NguyenHuynh-2004/Robot_kho/docs/TONG_HOP_DU_AN.docx

# Tổng hợp dự án xe tự hành AGV

Xe hai bánh vi sai chạy ROS 2 — ESP32, LiDAR, IMU, Nav2

Cập nhật: 01/10/2026 · Đang ở giai đoạn: định vị trên xe thật

Tóm tắt trong 30 giây

- Mục tiêu: xe tự chạy trong phòng. Người dùng chọn một ô trên lưới, xe tự tìm đường tới đó và tự tránh vật cản.
- Đã xong: chạy hoàn chỉnh trong mô phỏng. Trên xe thật: kết nối ổn định, lái tay được, hiệu chỉnh xong cảm biến, vẽ xong bản đồ phòng.
- Đang làm: cho xe tự biết mình đang ở đâu trên bản đồ (định vị bằng AMCL). Lần thử đầu còn lệch khoảng 8 cm, mục tiêu dưới 5 cm.
- Tiếp theo: sửa lỗi định vị, chỉnh lưới cho vừa phòng thật, rồi cho xe tự lái lần đầu.

# 1. Dự án làm gì

AGV (Automated Guided Vehicle) là xe tự hành. Xe trong dự án này nhỏ (đường kính 18 cm), có hai bánh chủ động phía sau và một bánh đa hướng phía trước. Xe rẽ bằng cách cho hai bánh quay khác tốc độ nhau — kiểu này gọi là “vi sai”.

Trên xe có ba loại cảm biến: LiDAR quét khoảng cách 360° xung quanh, encoder đếm số vòng quay của bánh, và IMU đo góc quay của xe. Vi điều khiển ESP32 đọc các cảm biến này rồi gửi qua Wi-Fi cho laptop. Laptop chạy ROS 2 để tính vị trí xe, vẽ bản đồ, lập đường đi, rồi gửi lệnh vận tốc ngược lại cho xe. Các thuật ngữ được giải thích ở Phụ lục A.

Khi hoàn thành, xe được dùng như sau:

- Bật xe và nạp bản đồ phòng đã lưu — xe tự xác định mình đang đứng ở đâu.
- Gõ số hàng và số cột của một ô trên lưới — chương trình grid_navigator tìm đường qua các ô bằng thuật toán BFS, rồi giao từng điểm cho Nav2 lái xe tới.
- Có vật cản chắn đường — xe dừng lại và tự tính đường vòng.

## Hai chế độ chạy

Chế độ | Dùng để | Tình trạng
Mô phỏng (Gazebo) | Thử thuật toán trên máy tính, không cần xe thật | Chạy được đầy đủ: lưới 5×5 trong phòng ảo 10×10 m, tránh vật cản
Xe thật | Chạy trong phòng thật bằng phần cứng | Đã lái tay và vẽ bản đồ; đang làm phần định vị

# 2. Phần cứng: dùng gì, để làm gì

Linh kiện | Dùng để làm gì | Ghi chú
ESP32 (có Wi-Fi) | “Bộ não” trên xe: đọc cảm biến, điều khiển động cơ, trao đổi dữ liệu với laptop qua Wi-Fi | Chạy micro-ROS; không làm tính toán nặng
LiDAR YDLIDAR X2 | “Mắt” của xe: đo khoảng cách 360° xung quanh để vẽ bản đồ, định vị và thấy vật cản | Khoảng 8.7 vòng quét/giây; dùng tới 8 m; nối 4 chân
2 động cơ JGA25-370 có encoder | Quay hai bánh sau; encoder đếm xung để biết bánh đã quay bao nhiêu | Đo được 2150 xung cho mỗi vòng bánh
Mạch L298N | Biến tín hiệu điều khiển yếu của ESP32 thành dòng điện đủ mạnh cho động cơ | Phải tháo jumper ENA/ENB thì mới chỉnh được tốc độ
IMU BNO055 | Đo góc quay (hướng) và tốc độ quay của xe | Gồm con quay, gia tốc kế và từ kế; nối I2C
Bánh đa hướng (phía trước) | Đỡ đầu xe, xoay tự do theo hướng xe chạy
Pin 7–12 V + mạch hạ áp 5 V | Cấp điện cho động cơ, ESP32 và LiDAR | Tất cả dây GND nối chung một điểm
Laptop (Windows + WSL2 Ubuntu) | Chạy ROS 2 và toàn bộ phần tính toán
Tay cầm chơi game USB | Lái xe bằng tay khi vẽ bản đồ | WSL không đọc được tay cầm, nên đọc trên Windows rồi chuyển vào qua mạng nội bộ

## Kích thước xe (đã đo thật)

Thông số | Giá trị
Khoảng cách giữa tâm hai bánh | 200 mm
Đường kính bánh | 64.5 mm
Bán kính lăn dùng trong tính toán | 32.81 mm — hiệu chỉnh bằng 3 lần chạy thử 2 m
Bề rộng lốp | 26 mm
Trục bánh sau so với tâm xe | lùi về sau 14 mm
Bánh đa hướng so với tâm xe | tiến lên trước 35 mm
Đường kính thân xe | 181.4 mm (bán kính an toàn dùng cho Nav2: 0.13 m)
Tốc độ tối đa | khoảng 0.40 m/s (động cơ 120 vòng/phút); Nav2 giới hạn 0.35 m/s

# 3. Phần mềm: dùng gì, để làm gì

Phần mềm | Chạy ở | Dùng để làm gì
ROS 2 Jazzy | Laptop | Nền tảng phần mềm robot. Mỗi chương trình (gọi là “node”) gửi và nhận dữ liệu qua các kênh có tên (“topic”), ví dụ /scan là ảnh quét LiDAR
Firmware esp32_agv_base.ino (tự viết) | ESP32 | Đọc LiDAR, encoder, IMU; gắn thời điểm đo; giữ tốc độ bánh bằng PID 50 lần/giây; gửi dữ liệu lên laptop
micro-ROS + micro_ros_agent | ESP32 + laptop | Cầu nối để ESP32 “nói chuyện” được với ROS 2 qua Wi-Fi (UDP cổng 8888)
Mô hình xe URDF + robot_state_publisher | Laptop | Mô tả vị trí LiDAR, IMU, bánh xe trên thân xe, để đổi tọa độ qua lại giữa các bộ phận
wheel_odometry.py (tự viết) | Laptop | Ghép encoder và IMU thành vị trí của xe (topic /odom)
slam_toolbox | Laptop | Vẽ bản đồ phòng trong lúc lái tay lần đầu
Nav2 | Laptop | Bộ tự lái: nạp bản đồ (map_server), định vị (AMCL), lập đường đi, điều khiển xe (MPPI), tránh vật cản
grid_navigator.py (tự viết) | Laptop | Chia phòng thành lưới ô, tìm đường BFS, gửi từng điểm cho Nav2, tìm đường mới khi bị chắn
Gazebo | Laptop | Mô phỏng căn phòng và chiếc xe để thử thuật toán
RViz | Laptop | Xem bản đồ, ảnh quét, vị trí xe và đường đi
Bộ công cụ kiểm tra tools/ (tự viết) | Laptop | Đo và chẩn đoán từng phần của hệ thống (xem Phụ lục B)

# 4. Hệ thống hoạt động thế nào

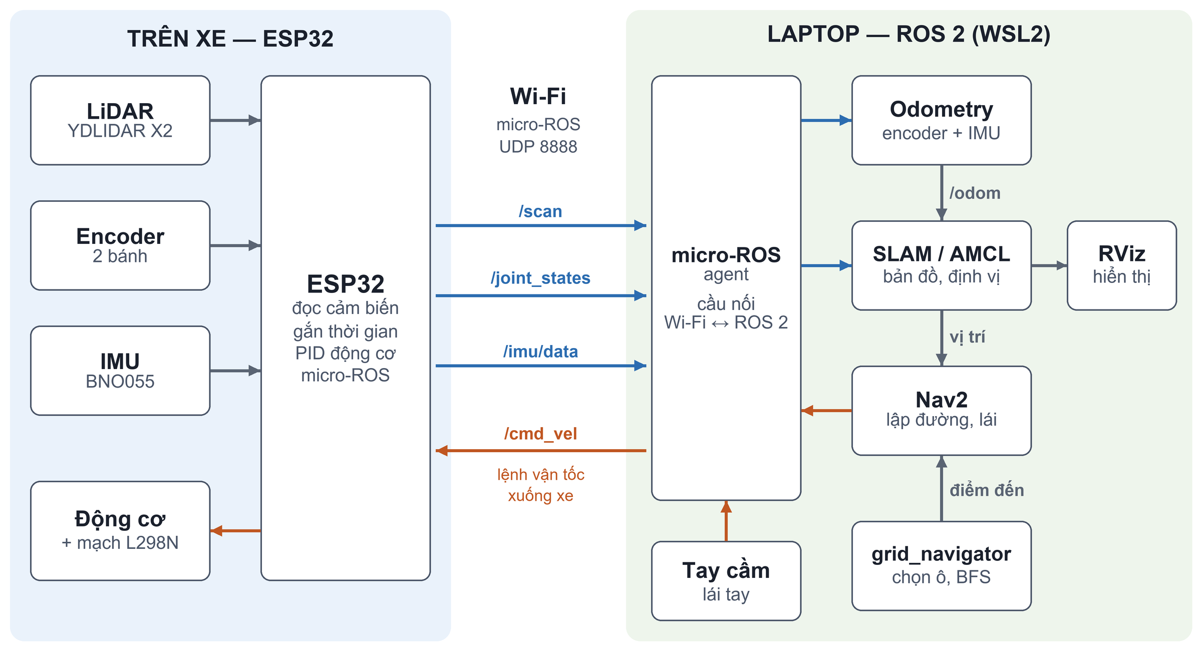
[picture p1: figure]

Hình 1. Đường đi của dữ liệu. Xanh: dữ liệu cảm biến từ xe lên laptop. Cam: lệnh vận tốc từ laptop xuống xe.

Vòng lặp sau chạy liên tục, nhiều lần mỗi giây:

- Đo: ESP32 đọc LiDAR (gửi /scan khoảng 8.7 lần/giây), encoder (/joint_states, 50 lần/giây) và IMU (/imu/data, 50 lần/giây).
- Tính vị trí: odometry cộng dồn chuyển động của bánh và góc quay từ IMU để biết xe đã đi tới đâu. Cách này nhanh nhưng sai số cứ cộng dồn dần.
- Sửa vị trí bằng bản đồ: SLAM (lúc vẽ bản đồ) hoặc AMCL (lúc chạy trên bản đồ có sẵn) so ảnh quét LiDAR với tường trên bản đồ để kéo vị trí về đúng chỗ.
- Lái: Nav2 lập đường đi, tính vận tốc cần có rồi gửi /cmd_vel xuống ESP32. ESP32 dùng PID giữ tốc độ mỗi bánh đúng như yêu cầu.

## Ba quyết định thiết kế quan trọng

1. ESP32 chỉ làm việc sát phần cứng, mọi tính toán nằm ở laptop. Nhờ vậy, sửa một thông số (ví dụ bán kính bánh) chỉ cần đổi tham số ROS và chạy lại — không phải nạp lại chip. Laptop cũng tính chính xác hơn, ESP32 nhẹ việc hơn.

2. Gửi giá trị cộng dồn, không gửi phần thay đổi. Wi-Fi thỉnh thoảng rơi gói (đã đo được có lúc mất liền 1.4 giây). Nếu ESP32 gửi “bánh vừa quay thêm bao nhiêu” thì mỗi gói rơi là mất hẳn đoạn đường đó. Gửi “tổng từ đầu tới giờ” thì gói sau tự bù cho gói rơi. Đã thử: bỏ 4/5 số gói, quãng đường tính ra vẫn đúng 2.000 m.

3. Mọi dữ liệu mang dấu thời gian chính xác. ESP32 đồng bộ đồng hồ với laptop, và mỗi ảnh quét được gắn thời điểm giữa vòng quét. Nhờ vậy khi xe vừa chạy vừa quét, ảnh quét không bị “trượt” khỏi bản đồ.

# 5. Những việc đã làm

Giai đoạn | Việc đã làm | Kết quả
1. Mô phỏng | Tạo workspace ROS 2, mô hình xe, phòng ảo 10×10 m, lưới 5×5; tìm đường BFS + Nav2; phát hiện vật cản và tìm đường vòng | Chạy được trong Gazebo
2. Kết nối ESP32 | Viết firmware chung cho xe thật; sửa lỗi dữ liệu chỉ lên 1 lần/giây; sửa đồng hồ ESP32 chỉ chính xác tới 1 giây; sửa chế độ truyền tin (QoS) | Dữ liệu lên đều 50 lần/giây, ảnh quét ~8.7 lần/giây, lệch thời gian chỉ vài chục mili-giây
3. Đấu nối và chiều quay | Nối LiDAR 4 chân; đảo chiều cả hai động cơ và encoder; đưa tay cầm từ Windows vào WSL | Đẩy cần tới thì xe tiến, đẩy trái thì xe rẽ trái
4. Mô hình xe | Đo kích thước thật; cập nhật mô hình URDF và cấu hình Nav2 (bán kính xe từ 0.6 m về 0.13 m) | Mô hình trong RViz khớp với xe thật
5. Hiệu chỉnh cảm biến | Đo số xung encoder bằng cách quay tay 10 vòng (1200 → 2150 xung/vòng); hiệu chỉnh bán kính lăn bằng 3 lần chạy 2 m; đo góc lắp LiDAR; đo độ lệch gyro | Sai số góc quay khoảng 1%; quãng đường các lần chạy chênh nhau khoảng 1%
6. Chuyển tính toán lên laptop | Viết wheel_odometry.py; ESP32 chỉ còn gửi dữ liệu thô | Sửa thông số không cần nạp lại chip
7. Vẽ bản đồ phòng thật | Lái tay với slam_toolbox; sửa thời điểm gắn cho ảnh quét; nội suy điểm quét trong firmware; lưu bản đồ real_room_map | Dao động góc khi quét: 13.8° → 3.2° Sai số điểm xa 4–6 m: 25.9 → 9.8 mm (thử trên máy tính) Bản đồ phòng ~6.3 × 5.3 m, ô 5 cm
8. Định vị (đang làm) | Tạo localization.launch.py (bản đồ + AMCL); chỉnh tham số AMCL; công cụ đo độ khớp ảnh quét với bản đồ; xử lý trường hợp IMU trả về toàn số 0 | Lần thử đầu: lệch trung vị ~8 cm (mục tiêu dưới 5 cm)

## Những lỗi khó nhất đã tìm ra

Phần lớn thời gian của dự án nằm ở việc tìm đúng nguyên nhân. Đây là những lỗi đáng nhớ nhất:

Hiện tượng | Nguyên nhân thật và cách sửa
Dữ liệu từ xe chỉ lên 1 lần/giây | Bộ thực thi của micro-ROS chờ tới 1 giây mỗi vòng lặp. Đặt thời gian chờ ngắn lại → lên đủ 50 lần/giây.
Đi một vòng không về chỗ cũ, bản đồ méo | Firmware khai báo encoder 1200 xung/vòng, thực tế là 2150 → xe tưởng mình đi xa gần gấp 1.8 lần. Đo lại bằng cách quay tay bánh 10 vòng.
Ảnh quét quay lệch so với xe | Góc lắp LiDAR khai báo sai 90°. Đặt một vật cản trước xe 1.2 m để đo rồi sửa lại góc lắp.
Ảnh quét trượt khỏi tường khi xe đang chạy | Ảnh quét được gắn thời điểm cuối vòng quét thay vì giữa vòng (lệch khoảng 0.06 giây). Sửa xong, dao động góc giảm từ 13.8° xuống 3.2°.
Điểm ở xa (trên 2.5 m) nhảy loạn | Firmware làm tròn góc của mỗi điểm về ô góc gần nhất; sai số này tăng theo khoảng cách. Đổi sang nội suy giữa các điểm đo thật.
Xe quay mà trên RViz đứng yên, định vị lạc (mới gặp) | Sau khi chỉ bấm nút reset ESP32, IMU BNO055 trả về toàn số 0 (nút reset không khởi động lại IMU). Odometry giờ tự phát hiện và tạm dùng bánh xe để tính góc. Cách khắc phục: tắt hẳn nguồn xe rồi bật lại.

# 6. Tình trạng hiện tại

Hạng mục | Tình trạng | Ghi chú
Mô phỏng Gazebo + điều hướng theo lưới | Xong
Kết nối ESP32 ↔ laptop | Xong | 50 lần/giây, có đồng bộ thời gian
Lái tay bằng tay cầm | Xong
Hiệu chỉnh encoder, bánh xe, LiDAR, IMU | Xong | nên đo lại góc lắp LiDAR sau lần xe bị ngã
Bản đồ phòng thật | Xong | real_room_map, ô 5 cm
Định vị AMCL trên xe thật | Đang làm | lệch ~8 cm; có lúc lạc tới 37 cm / 13°
Lưới điều hướng cho phòng thật | Chưa làm | lưới hiện tại dành cho phòng ảo 10×10 m
Nav2 tự lái xe thật | Chưa làm | chưa chạy lần nào

## Các số đo chính

Chỉ số | Giá trị
Tần số ảnh quét LiDAR (/scan) | ~8.7 lần/giây
Tần số encoder và IMU | 50 lần/giây
Sai số góc quay của odometry (quay 683°, so với LiDAR) | ~1%
Độ lặp lại quãng đường (3 lần chạy 2 m) | chênh nhau ~1%
Độ khớp ảnh quét với bản đồ khi xe được đặt đúng chỗ | 5 cm (bằng 1 ô bản đồ)
AMCL lần thử đầu: lệch trung vị khi đứng yên / khi chạy | 8.3 cm / 8.6 cm
Độ lệch gyro còn lại khi đứng yên (laptop tự trừ) | 0.0115 rad/s

# 7. Tiếp theo sẽ làm gì

Làm lần lượt từng bước. Bước trước đạt yêu cầu thì mới sang bước sau.

# | Việc cần làm | Đạt khi

1 | Kiểm tra lại định vị sau khi khởi động sạch: tắt hẳn nguồn xe để IMU khởi động lại, chạy chế độ góc quaternion, lái quanh phòng trong khi đo bằng check_yaw_sources.py và check_scan_fit.py. | Biết chắc từ kế của IMU có kéo lệch góc quay hay không
2 | Nếu từ kế gây lệch: chuyển BNO055 sang chế độ IMUPLUS (chỉ dùng con quay + gia tốc kế, bỏ từ kế). Sửa 1 dòng firmware, bạn nạp lại chip. | Góc quay không còn lệch theo vị trí trong phòng
3 | Tinh chỉnh AMCL. Mô hình cảm biến đang để mặc định (giả định LiDAR sai tới 20 cm) — quá “dễ dãi” nên vị trí ước lượng không chụm lại được. | Lệch trung vị dưới 5 cm; AMCL tự báo sai số vài cm / vài độ, cả khi đứng yên lẫn khi chạy
4 | Làm firmware chắc chắn hơn: tự phát hiện IMU trả về số 0 và khởi động lại cảm biến; xem lại bước trừ độ lệch gyro lúc bật máy; bỏ các dòng chẩn đoán Serial không cần nữa. | Bấm reset ESP32 không còn làm hỏng dữ liệu IMU
5 | Chỉnh grid_navigator cho phòng thật. Lưới hiện tại dành cho phòng 10×10 m (các ô cách nhau 2 m, từ −4 m đến +4 m) và xe bán kính 0.6 m; phòng thật chỉ khoảng 6.3 × 5.3 m và xe chỉ 0.13 m. | Mọi ô trên lưới đều nằm trong vùng trống của bản đồ thật
6 | Cho Nav2 tự lái lần đầu: tốc độ thấp, có người đứng cạnh, đi các ô gần trước rồi xa dần; sau đó thử đặt vật cản chắn đường. | Xe tới đúng ô (lệch dưới 25 cm — ngưỡng tới đích của Nav2) và tự tìm đường vòng khi bị chắn
7 | Hoàn thiện: ghi lại các số đo cuối cùng, cập nhật hướng dẫn chạy. | Người khác làm theo hướng dẫn là chạy được

Hai kết quả đo còn chờ từ các bước trước: góc lắp LiDAR sau lần xe bị ngã (check_lidar_offset.py) và độ nhiễu ảnh quét sau khi nạp firmware nội suy (check_scan_noise.py).

# Phụ lục A — Giải thích thuật ngữ

Thuật ngữ | Nghĩa
AGV | Xe tự hành — xe tự di chuyển tới nơi cần đến mà không cần người lái
ROS 2 | Bộ khung phần mềm cho robot. Các chương trình nhỏ (node) trao đổi dữ liệu với nhau qua các kênh có tên (topic)
Topic | Một kênh dữ liệu có tên, ví dụ /scan (ảnh quét), /odom (vị trí), /cmd_vel (lệnh vận tốc)
LiDAR | Cảm biến quay tròn, bắn tia laser để đo khoảng cách tới mọi vật xung quanh
Encoder | Bộ đếm xung gắn trên trục động cơ; đếm xung để biết bánh đã quay bao nhiêu
IMU | Cảm biến quán tính. BNO055 có con quay (đo tốc độ quay), gia tốc kế và từ kế (la bàn điện tử)
Quaternion | Cách biểu diễn hướng của vật bằng 4 con số; từ đó tính ra góc quay của xe
Odometry | Ước lượng vị trí bằng cách cộng dồn chuyển động của bánh xe (và góc từ IMU). Nhanh, nhưng sai số tích lũy dần
SLAM | Vừa vẽ bản đồ vừa tự định vị trên chính bản đồ đang vẽ
AMCL | Định vị trên bản đồ có sẵn: rải hàng nghìn “giả thuyết vị trí”, giữ lại những giả thuyết làm ảnh quét khớp với tường nhất
Nav2 | Bộ điều hướng của ROS 2: lập đường đi, điều khiển xe, tránh vật cản
TF | Hệ thống quản lý các hệ tọa độ: bản đồ (map), odometry (odom), thân xe, LiDAR
PID | Bộ điều khiển tự chỉnh điện áp động cơ để tốc độ bánh bám đúng tốc độ yêu cầu
QoS | Chính sách truyền tin của ROS 2: bắt buộc tới nơi, hay chấp nhận rơi gói để nhanh hơn
micro-ROS | Phiên bản ROS 2 rút gọn chạy được trên vi điều khiển như ESP32
BFS | Thuật toán tìm đường theo chiều rộng trên lưới ô — luôn tìm ra đường qua ít ô nhất
Costmap | Bản đồ “chi phí”: vùng sát vật cản bị tô đậm để Nav2 lái xe tránh xa
WSL2 | Cách chạy Ubuntu (Linux) bên trong Windows; ROS 2 chạy trong đó

# Phụ lục B — Bộ công cụ kiểm tra

Các script trong thư mục tools/ chỉ đọc dữ liệu, không điều khiển xe. Chạy trong WSL: cd ~/robot_ws_3 && python3 tools/<tên>.py.

Công cụ | Dùng để
check_qos.py | Kiểm tra chế độ truyền tin giữa ESP32 và laptop có khớp nhau
check_tf.py | Kiểm tra cây tọa độ (TF) đủ và không bị trễ
check_esp32_rates.py | Đo nhịp gửi và độ trễ dữ liệu từ ESP32
check_direction.py | Kiểm tra xe chạy đúng chiều theo lệnh
check_encoder_ppr.py | Kiểm tra số xung encoder trên mỗi vòng bánh
check_odom_scale.py | So quãng đường odometry với quãng đường thật (chạy 2 m)
check_gyro_bias.py | Đo độ lệch của gyro khi xe đứng yên
check_lidar_angle.py | So góc quay đo bằng LiDAR với gyro và quaternion
check_lidar_offset.py | Đo góc lệch giữa ảnh quét và mũi xe
check_scan_noise.py | Đo độ nhiễu ảnh quét theo khoảng cách
check_slam_drift.py | Theo dõi SLAM phải sửa vị trí xe bao nhiêu
check_scan_fit.py | Đo ảnh quét lệch khỏi tường bản đồ bao nhiêu, kèm độ bất định của AMCL
check_yaw_sources.py | So ba nguồn góc quay (quaternion, gyro, bánh xe) để tìm lỗi từ kế
windows_gamepad_bridge.py + joy_udp_bridge.py | Đưa tay cầm từ Windows vào WSL
firmware/encoder_test | Chương trình Arduino riêng: đếm xung encoder khi quay tay bánh

# Phụ lục C — Lệnh chạy nhanh (xe thật)

Chi tiết từng bước nằm trong docs/HUONG_DAN_CHAY.md. Mỗi lệnh chạy trong một terminal WSL riêng, ở thư mục ~/robot_ws_3.

Cầu nối ESP32 (luôn chạy đầu tiên, rồi bật nguồn xe):

ros2 launch my_bot_bringup bringup_real.launch.py

Vẽ bản đồ:

ros2 launch my_bot_bringup slam.launch.py use_sim_time:=false

Lưu bản đồ (khi slam_toolbox còn đang chạy):

ros2 run nav2_map_server map_saver_cli -f src/my_bot_bringup/config/real_room_map

colcon build --symlink-install

Định vị trên bản đồ đã lưu (tắt slam_toolbox trước):

ros2 launch my_bot_bringup localization.launch.py use_sim_time:=false

Tay cầm — một lệnh trên Windows, hai lệnh trong WSL:

python \\wsl.localhost\Ubuntu\home\huynh\robot_ws_3\tools\windows_gamepad_bridge.py

python3 tools/joy_udp_bridge.py

ros2 launch my_bot_bringup joy_teleop.launch.py start_joy_node:=false

Xem trên RViz:

rviz2 -d /opt/ros/jazzy/share/nav2_bringup/rviz/nav2_default_view.rviz

Mô phỏng (ba terminal, mở lần lượt):

ros2 launch my_bot_bringup gazebo.launch.py

ros2 launch my_bot_bringup navigation.launch.py

python3 grid_navigator.py

Lưu ý: khi cần khởi động lại xe, hãy tắt hẳn nguồn rồi bật lại — chỉ bấm reset ESP32 thì IMU không khởi động lại theo.

Tổng hợp dự án AGV — ROS 2 + ESP32
