NguyenHuynh-2004/Robot_kho/docs/sa_ban_5x5_preview.png

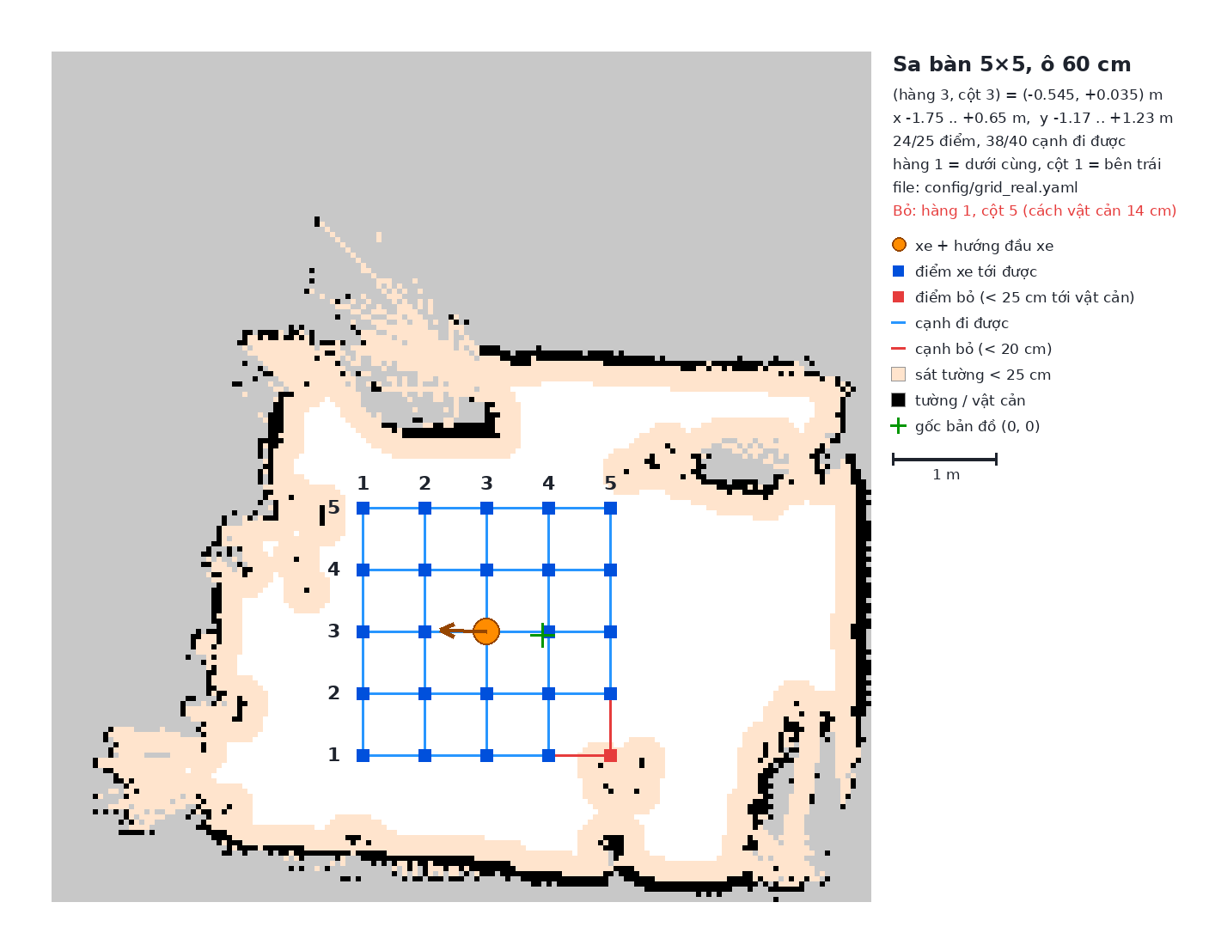
docs/sa_ban_5x5_preview.png
