NguyenHuynh-2004/Robot_kho/docs/sa_ban_5x5_preview_mo_phong.png

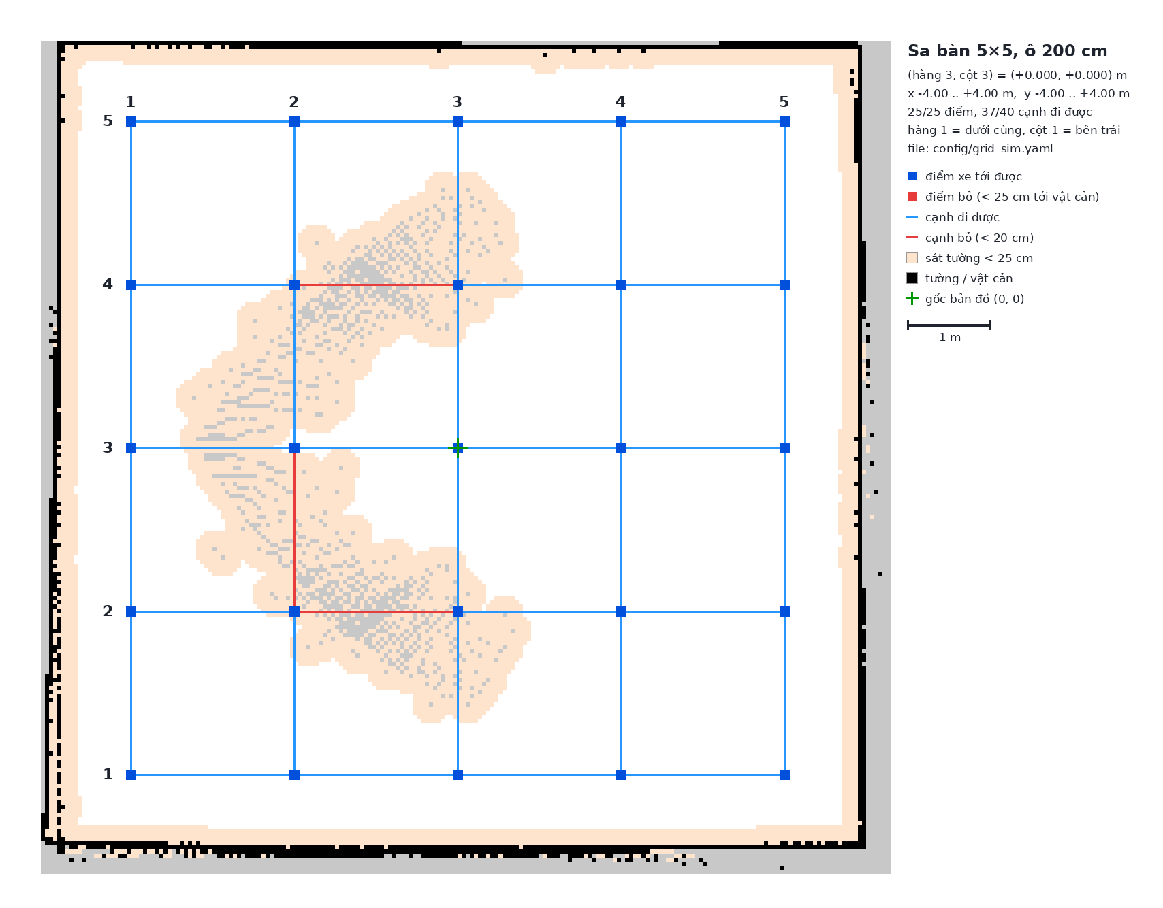
docs/sa_ban_5x5_preview_mo_phong.png
