NguyenHuynh-2004/Robot_kho/src/my_bot_bringup/worlds/textures/aruco_14.png

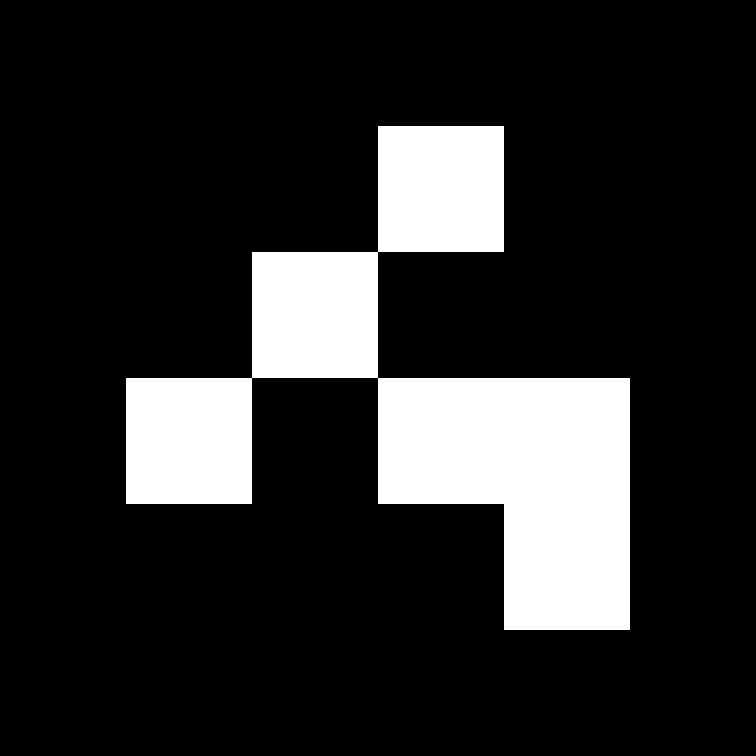
src/my_bot_bringup/worlds/textures/aruco_14.png
