NguyenHuynh-2004/Robot_kho/src/my_bot_bringup/worlds/textures/aruco_22.png

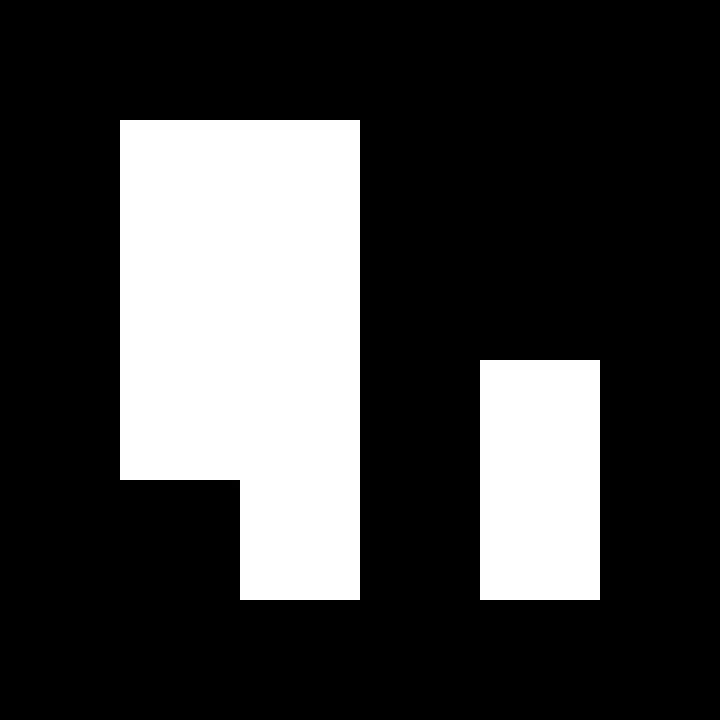
src/my_bot_bringup/worlds/textures/aruco_22.png
