NguyenHuynh-2004/Robot_kho/(commit log)

2026-09-19 Khoi tao workspace AGV dieu huong luoi 5x5 + sua loi tranh vat can
    Commit dau tien cua workspace: mo phong AGV tu hanh trong phong 10x10m
    (Gazebo Harmonic + Nav2 + slam_toolbox), nguoi dung nhap toa do luoi va xe
    tu tim duong bang BFS, tu ne vat can dong.
    Kem theo cac sua loi da duoc kiem chung bang chay that trong mo phong:
    Nav2 (config/navigation.yaml)
    - Thay footprint 30x9cm bang robot_radius 0.6 cho dung kich thuoc xe that
    (chassis ban kinh 0.5m, banh xe loi ra 0.57m).
    - inflation_radius 0.35 -> 0.75; local costmap 3x3m -> 6x6m cho du tam
    nhin cua MPPI (lookahead 1.4m).
    - Them set_initial_pose de AMCL tu dinh vi luc khoi dong, khoi phai bam
    "2D Pose Estimate" trong RViz moi lan c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
2026-09-19 Giu thu muc meshes/ trong git de ban clone moi build duoc
    meshes/ dang rong nen git khong track, trong khi CMakeLists.txt cua
    my_bot_description co install(DIRECTORY description meshes ...). Clone sach
    ve se khong co thu muc nay va colcon build that bai ngay o buoc install:
    ament_cmake_symlink_install_directory(...)
    Failed <<< my_bot_description [exited with code 1]
    Them .gitkeep de thu muc luon ton tai.
2026-09-27 Firmware ESP32 hop nhat cho xe that + tach cau hinh sim/that
    Gop 3 sketch Arduino thanh mot firmware duy nhat chay tren 1 con ESP32,
    thay the hoan toan plugin DiffDrive va gpu_lidar cua Gazebo de Nav2 chay
    tren xe that y het mo phong.
    firmware/esp32_agv_base/esp32_agv_base.ino
    - Nhan /cmd_vel
    - Phat /scan /odom /tf (odom->base_footprint) /imu/data
    - LiDAR giu nguyen tu ydlidar_microros.ino (ping-pong buffer, ngan sach MTU)
    - PID + feedforward + bao ve sai chieu/ket banh lay tu motor_1_wheel_l298n.ino,
    nhan doi cho 2 banh. Dung he so ban L298N (Kf 1.8, deadband 30, PWM 5 kHz),
    KHONG phai ban BTS7960.
    - Giu trinh tu ha ENA truoc khi lat IN1/IN2 de tranh soc dong qua cau H.
    - Khung micro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
2026-09-27 Sua loi bien dich firmware va ghi lai thiet lap board
    Da bien dich thuc su bang arduino-cli 1.5.2 + core esp32 3.3.8 (truoc do
    chua co toolchain nen chi kiem tra tinh duoc).
    Loi that duoc phat hien:
    geometry_msgs__msg__TransformStamped__init was not declared in this scope
    tf2_msgs/msg/tf_message.h chi keo struct cua TransformStamped chu khong keo
    detail/transform_stamped__functions.h. Them include tuong minh.
    Ket qua sau khi sua:
    Partition mac dinh : 1072922 byte = 81% cua 1310720 (sat tran)
    Huge APP : 1072954 byte = 34% cua 3145728 (nen dung)
    RAM: 122744 byte = 37%
    Ghi thiet lap board va danh sach thu vien vao dau file.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
2026-09-27 slam.launch.py: cho phep tat use_sim_time de ve ban do tren xe that
    Truoc day gia tri bi dong cung 'true' nen tren xe that slam_toolbox se doi
    /clock mai mai va khong xu ly scan nao. Gio la launch argument, mac dinh
    van true cho mo phong.
2026-09-30 Firmware: chuyen sang encoder 1 kenh (chi kenh A)
    Nguoi dung chi noi kenh A cua encoder. Kenh A mot minh khong cho biet chieu
    quay nen phai doi cach doc va bo mot lop bao ve.
    - attachHalfQuad -> attachSingleEdge. PCNT cua ESP32 bat buoc co mot chan
    "level" quyet dinh chieu dem, nen ghim ENC_DIR_PIN (GPIO 13) xuong GND:
    muc LOW => luon dem tang. Bat them pulldown noi bo lam du phong.
    Khong dung GPIO 19 cho viec nay du driver X2/X2L khong cham chan EN, vi doi
    sang X4 thi driver se xuat ra chan do va dam voi day GND -> ngan mach.
    - Chieu quay suy tu w.last_direction (chieu cau H dang duoc cap), khong con
    lay tu encoder.
    - BO bao ve "banh quay nguoc chieu PWM": no so sanh dau PWM voi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
2026-09-30 Revert "Firmware: chuyen sang encoder 1 kenh (chi kenh A)"
    This reverts commit baf3de2856a65efc0c9ab114618f68b044b97ee6.
2026-09-30 Firmware: LiDAR 4 chan (VCC, GND, Tx, PWM) - bo chan TX va EN
    LiDAR cua nguoi dung chi co 4 chan, khong co chan Rx. Kiem tra thu vien LDS:
    LDS_YDLIDAR_X2_X2L::start() chi goi enableMotor(true) + postInfo(), khong ghi
    byte nao ra UART (grep writeSerial/sendCommand/getDeviceInfo = 0 ket qua), va
    enableMotor() duoc override nen chi dung LDS_MOTOR_PWM_PIN chu khong dung
    LDS_MOTOR_EN_PIN nhu lop cha X4. Vay LiDAR nay la loai chi phat mot chieu.
    - LIDAR_TX_PIN 17 -> -1 (giai phong GPIO 17)
    - LIDAR_EN_PIN 19 -> -1 (giai phong GPIO 19)
    - Doi uint8_t -> int8_t de chua duoc gia tri -1, dung kieu ma
    HardwareSerial::begin(baud, cfg, rxPin, txPin) mong doi.
    - Them guard "if (pin < 0) return" trong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
2026-09-30 Them dieu khien bang tay cam de ve ban do
    Can analog cho toc do muot hon ban phim nen ban do SLAM it nhoe hon.
    - config/joy_teleop.yaml: chinh theo gioi han cua xe (vx_max 0.5 m/s,
    wz_max 1.5 rad/s trong navigation.yaml). Toc do thuong 0.25 m/s cho ban do
    min, giu RB de len turbo 0.5 m/s. Nut chet LB phai giu moi di duoc.
    autorepeat_rate 20 Hz la bat buoc: firmware co CMD_VEL_TIMEOUT_MS 500ms nen
    neu khong phat lai lien tuc thi xe tu dung khi giu can im.
    publish_stamped_twist: false vi firmware nhan geometry_msgs/Twist.
    - launch/joy_teleop.launch.py: joy_node + teleop_twist_joy, co tham so
    device_id / cmd_vel_topic / use_sim_time.
    - package.xml: them exec_depend joy, teleop_twis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
2026-09-30 Tay cam tren WSL: cau noi UDP tu Windows, vi kernel khong co driver joystick
    Sua lai ket luan truoc do. Truoc tôi chi kiem CONFIG_INPUT_EVDEV (co, =m) roi
    ket luan usbipd se chay duoc. Kiem tiep thi thay:
    # CONFIG_INPUT_JOYSTICK is not set
    Ca phan he driver joystick khong duoc bien dich, khong co xpad.ko, khong co
    thu muc drivers/input/joystick, va khong phai dang module nen khong nap duoc.
    usbipd van gan duoc thiet bi vao WSL nhung khong driver nao bind, khong co
    /dev/input/event* cho tay cam, va joy_node thay con so khong. Muon dung
    usbipd thi phai build lai kernel WSL - khong lam.
    Giai phap khong can kernel: doc tay cam ben Windows roi day qua UDP.
    - tools/windows_gamepad_bridge.p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
2026-09-30 bringup_real.launch.py: bao loi tu te khi thieu micro_ros_agent
    Nguoi dung chay launch va nhan stack trace "package 'micro_ros_agent' not
    found" ma khong biet phai lam gi.
    Nguyen nhan that: goi apt ros-jazzy-micro-ros-agent KHONG TON TAI (apt chi co
    micro-ros-msgs va micro-ros-diagnostic-*), nen huong dan cai bang apt truoc do
    la sai. Tren may nay agent da duoc build san o ~/microros_ws - chi thieu buoc
    source workspace do.
    - Kiem tra goi ton tai truoc khi tao Node. Thieu thi bo qua node agent va in
    huong dan ro rang, cac node con lai (robot_state_publisher,
    joint_state_publisher) van khoi dong binh thuong.
    - Docstring ghi dung duong dan ~/microros_ws va phuong an Docker.
    Co-Authored-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
2026-09-30 Them docs/HUONG_DAN_CHAY.md va ghi nhan ket qua do tren phan cung that
    Huong dan day du cho ca hai che do, ghi ro terminal nao chay lenh gi, so do
    noi day 14 chan, quy trinh kiem tra phan cung, va bang tra su co.
    Ket qua do tren ESP32 THAT (agent o ~/microros_ws, client_key 0x11111111):
    - Agent tao dung 4 publisher + 1 subscriber nhu firmware dinh nghia.
    - /scan frame=lidar_link, 320 tia, ~200 tia hop le, 0.55-5.92m,
    scan_time=0.117s => lidar quay dung 8.5 Hz
    - /odom frame odom->base_footprint, dinh dang dung
    - /imu frame=imu_link, gyro ~0 khi dung yen, |accel|=10.08 m/s2
    => XAC NHAN don vi IMU dung la m/s2, gia dinh truoc do chinh xac
    - /tf odom->base_footpri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
2026-09-30 Firmware: them do luong de tim nut co chai 1 Hz
    Log Serial cua nguoi dung loai bo cac nghi van truoc do: dong log dung nhip
    1.00s (Core 1 khoe), loi pub = 0 (rcl_publish luon OK), scan 8.8 Hz, gyroZ va
    odom deu cap nhat (motor_task chay dung 50 Hz nen khong bo doi ros_task).
    Vay publish thanh cong nhung chi ~4 message/giay ra khoi chip.
    Them dem va do thoi gian thay vi tiep tuc doan:
    - ros_loops: so vong ros_task moi giay
    - pub_scan / pub_odom / pub_imu: so lan publish OK moi giay
    - t_imu_max: lau nhat cua 1 lan doc BNO055 (3 giao dich I2C) + gui
    - t_pub_max / t_scan_max: lau nhat cua 1 lan gui odom+tf / scan
    - t_loop_max: lau nhat cua ca 1 vong ros_task
    In tat ca o dong thu hai cua log mo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
2026-09-30 Firmware: sua loi 1 Hz - dat timeout cho rclc executor
    Do luong tren phan cung da chi dung thu pham:
    ros_task 1 vong/s | pub/s: scan 1 odom 1 imu 1
    max us: imu 5310, odom 2499, scan 1610, ca_vong 999633
    Tong cac khau publish chi ~9 ms nhung ca vong lap mat 999633 us. Phan khong do
    duoc la rclc_executor_spin_some, va 1.000 s khop dung DEFAULT_WAIT_TIMEOUT_NS
    cua rclc (1000 ms): rclc_executor_init dat executor->timeout_ns bang gia tri do
    va spin_some dung no chu khong dung tham so RCL_MS_TO_NS(1) truyen vao.
    Khi Nav2 chua chay, khong co /cmd_vel gui den nen rcl_wait cho het 1000 ms moi
    vong -> ros_task 1 vong/giay -> moi topic tut xuong 1 Hz, du rcl_publish luon
    tra ve OK (loi pub =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
2026-09-30 Firmware: spin_some khong chan - xac dinh duoc co che bang thi nghiem
    Ban sua truoc (rclc_executor_set_timeout) KHONG an: do lai tren phan cung van
    thay spin = 965..990 ms, ca_vong ~1000 ms, tuc spin chiem 98%.
    Thi nghiem xac dinh dung co che: rclc_executor_spin_some CHAN cho tới khi CO
    DU LIEU DEN, khong phai het timeout. Bom /cmd_vel toan 0 o 20 Hz (xe khong
    chay) roi do lai tu phia ROS:
    khong co /cmd_vel : /scan 0.2 Hz /odom 0.2 Hz /imu 0.2 Hz /tf 0.2 Hz
    /cmd_vel 20 Hz : /scan 7.9 Hz /odom 17.9 Hz /imu 17.5 Hz /tf 17.5 Hz
    Nhip phat bam dung nhip /cmd_vel den. Vi moi lenh publish nam SAU spin trong
    cung vong lap, spin bi chan la ca ros_task dung.
    Sua:
    - spin_some(&exec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
2026-09-30 firmware: sua timestamp chi co do phan giai 1 giay
    Do stamp tho cua /odom tu phia ROS cho thay truong nanosec dung yen hang
    chuc giay, chi sec tang, va chi doi dung luc rmw_uros_sync_session() chay
    -> dong ho ben trong rmw_uros_epoch_nanos() co do phan giai ~1 giay. 50
    message/giay deu mang cung mot mocthoi gian, du de pha AMCL/TF/costmap.
    - fill_stamp() neo epoch tu agent MOT lan roi tu chay bang esp_timer_get_time()
    - clock_anchor_bootstrap() cho den dung luc dong ho tho nhay de moc khong bi
    sai lech toi 1 giay do lam tron, va in ra buoc nhay do duoc
    - clock_reanchor() keo 1/5 khoang lech moi lan sync, tranh stamp giat lui
    - sync_session 10 s -> 60 s, ping_agent 2 s -> 5 s: ca hai deu c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
2026-09-30 firmware: sua offset dong bo sai 1 giay va bo ping chan giua duong
    Do tu phia ROS sau ban truoc: nhip stamp da dung (40/40 message co moc rieng,
    buoc 19.988-20.013 ms) nhung ca cum bi tre 1.158 s so voi dong ho may -> Nav2
    se loai het vi qua cu. Nguyen nhan: sync_session tinh offset =
    ((t2-t1)+(t3-t4))/2 voi t1, t4 doc tu chinh dong ho tho 1 giay do, nen ban
    than offset da sai toi 1 giay; neo chinh xac cach nao cung khong cuu duoc.
    - wait_for_epoch_tick(): bat canh dong ho tho vua nhay - luc do no dung
    - clock_anchor_bootstrap(): cho tick -> sync NGAY -> cho tick -> neo
    - clock_resync() thay clock_reanchor(), canh tick y het, van keo 1/5
    Nghen con lai: cot sync do duoc 127 ms, 228 ms va mo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
2026-09-30 docs: cap nhat huong dan chay theo ket qua do tren xe that
    - B1: them muc bam nut BOOT khi nap, va 5 dong boot phai thay
    - B1: giai thich 4 dong loi gpio_pulldown_en/gpio_pullup_en la vo hai
    - B3: them buoc 5 kiem pub/s, va mot muc doc dong chan doan (bang 8 cot)
    - B5: doi sang tools/check_esp32_rates.py, kem canh bao ve cach do sai
    - Bang tra su co: them 6 dong (boot mode 0x13, spin chan, dong ho 1 giay,
    offset sai 1 giay, loi gpio, dinh sync)
    - Pham vi kiem chung: viet lai theo so do duoc, tach ro phan chua kiem chung
    Them tools/check_esp32_rates.py: do thu dong, moi luot mot topic, depth=1.
2026-09-30 firmware: /tf va /odom phai la RELIABLE, khong the de best-effort
    Trieu chung tren xe that: RViz bao "Frame [map] does not exist" va "No map
    received", log slam_toolbox day "Message Filter dropping message: frame
    lidar_link ... queue is full".
    Nguyen nhan: firmware phat ca 4 topic o BEST_EFFORT, nhung
    tf2_ros::TransformListener LUON subscribe /tf o RELIABLE. QoS lech thi ROS 2
    khong chuyen mot message nao va chi ghi mot dong WARN chim trong log. Hau qua
    day chuyen: tf2 khong nhan gi -> frame odom khong ton tai trong cay TF ->
    message filter cua slam_toolbox cho mai mot transform khong bao gio den -> loai
    sach scan -> khong co ban do.
    Do duoc bang subscriber thu ca hai che do: ca 4 topic vo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
2026-09-30 docs: them dong RobotModel bi tat vao bang tra su co
    Xac nhan tren may: /robot_description co 8 link, 7 joint, 0 mesh; cay TF day du
    map -> odom -> base_footprint -> ... -> lidar_link. Nen RobotModel khong hien
    chi vi display bi tat trong nav2_default_view.rviz.
2026-09-30 slam: chinh tham so cho het cham den roi rac tren ban do
    Do tren xe that (tools/check_scan_noise.py, 40 vong quet, xe dung yen):
    bin trong 84/320 = 26% moi vong
    diem co don 584/9442 = 6.2% so tia hop le
    bin dao dong>0.3m 17/249 = 6.8%
    bien do dao dong trung vi 21 mm, 90% duoi 206 mm
    Tuc phan lon tia rat on dinh (21 mm la tot voi LiDAR gia re) nhung co duoi
    ~6% tia rac. Rieng no khong du lam ban do den nhu vay - nut that la
    occupancy_threshold mac dinh 0.1: o duoc to den khi trung/di-qua > 0.1, tuc
    1 tia rac tren 9 lan di qua sach cung du.
    Them src/my_bot_bringup/config/slam_async.yaml (ban sao cua slam_toolbox,
    chinh 4 tham so) va noi vao slam.launch.py qua slam_params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
2026-09-30 tools: them check_direction.py
    Phan biet hai nguyen nhan cua cung mot trieu chung xe chay nguoc: tay cam dao
    dau (chi lai tay bi anh huong) hay ca hai dong co lap nguoc (moi thu nguoc va
    odometry noi doi). Doc /joy, /cmd_vel, /odom cung luc; /cmd_vel la lenh nam
    giua hai ben nen dau cua no phan xu duoc.
2026-10-01 firmware: dao chieu ca hai dong co va ca hai encoder
    Do bang tools/check_direction.py tren xe that:
    /joy axes[1] = +1.00 -> /cmd_vel linear.x = +0.250 -> odom = +0.260
    Lenh dung la TIEN, nhung xe chay LUI. Chuoi phan mem (tay cam -> teleop ->
    cmd_vel) sach hoan toan; loi nam o dau day dong co.
    Hau qua nang hon ca chuyen lai nguoc: odometry noi doi. USE_GYRO_FOR_YAW = 1
    nen goc quay lay tu gyro la dung that, con quang duong lay tu encoder thi
    nguoc dau -> hai nguon danh nhau. Day nhieu kha nang moi la ly do chinh khien
    ban do SLAM ra hinh khoi tron meo, chu khong phai nhieu LiDAR.
    Dao ca bon co, khong the dao rieng: bo cu von nhat quan (PID khong keu gi),
    nghia la xung encoder thô kh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
2026-10-01 mo hinh xe: thay so dat tam bang kich thuoc do that
    URDF cu mo ta mot chiec xe duong kinh 1 m (chassis ban kinh 0.5, hai banh cach
    nhau 1.1 m) - khong dinh gi den xe that. Kich thuoc do bang thuoc:
    hai banh sau cach nhau 200 mm
    truc banh sau lui 14 mm sau tam
    banh da huong truoc tien 35 mm truoc tam
    duong kinh banh sau 64.5 mm
    duong kinh than xe 181.40 mm
    robot.urdf.xacro viet lai theo tham so xacro, moi hinh hoc va moment quan tinh
    deu suy ra tu cac so tren. Tach rieng hai nhom: nhom DA DO va nhom CHUA DO
    (be day than, be rong lop, ban kinh bi, chieu cao LiDAR/IMU, khoi luong) de
    sau nay do duoc thi biet sua o dau.
    Ba cho khac phai khop theo, neu kh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
2026-10-01 mo hinh xe: wheel_width 26 mm da duoc do, chuyen sang nhom da do
    Gia tri khong doi (dung bang so dat tam truoc do) nen hinh hoc va robot_radius
    giu nguyen. Nhung gio ca ba so trong phep tinh robot_radius deu la so do that:
    sqrt(0.046^2 + 0.113^2) = 0.122 -> robot_radius 0.13
2026-10-01 launch: ep kieu str cho robot_description trong bringup_real
    Loi: "Unable to parse the value of parameter robot_description as yaml".
    Command() tra ve mot substitution, va launch_ros thu yaml.safe_load chuoi ket
    qua de doan kieu. Chuoi do la ca file URDF. Chi can trong no co mot dong ket
    thuc bang dau hai cham la YAML coi do la khoa cua mot mapping va bao loi.
    URDF truoc day khong co dong nao nhu vay nen yaml.safe_load tra ve str va moi
    thu chay - do la an may chu khong phai dung. URDF moi co dong chu thich
    "<!-- BA CHO KHAC PHAI KHOP VOI NHOM 1:" ket thuc bang dau hai cham nen lo ra.
    Da kiem chung bang cach chay yaml.safe_load tren dau ra cua ca hai ban:
    ban cu -> str
    ban moi -> Scan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
2026-10-01 tools: them check_lidar_angle.py - do anh quet co bi lat guong khong
    Ban do moi nhat ra tung mang trang roi rac, ria tua hinh nan quat, gan nhu
    khong con tuong den. Do khong phai "it nhieu hon" ma la diem trung tuong bi
    rai ra qua nhieu o, nen khong o nao du ti le trung/di-qua -> loi o uoc luong
    vi tri, khong phai o nguong occupancy.
    Suy luan thu hep nghi pham:
    LIDAR_ANGLE_OFFSET_DEG sai KHONG gay ra duoc canh nay. Lech goc co dinh chi
    la mot phep quay co dinh cua khung lidar; cac vong quet van nhat quan voi
    nhau, ban do van sac net, chi bi xoay so voi huong xe.
    LIDAR_ANGLE_FLIP sai thi gay duoc. Lat guong khong phai phep quay: xe quay
    trai thi anh quet dung phai xoay phai trong k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
2026-10-01 tools: sua loi tich phan gyro, them check_odom_scale.py
    check_lidar_angle tren xe that ra ti so -1.13: dau DUNG (anh quet xoay nguoc
    chieu xe) nen LIDAR_ANGLE_FLIP khong phai thu pham. Nhung 13% do lon la loi
    cua chinh cong cu, khong phai cua xe:
    gyro_between() chi cong cac mau nam han trong [t0,t1] va bo hai doan cut o hai
    dau. Mau gyro cach nhau ~21 ms con khoang giua hai vong quet ~113 ms, nen moi
    lan bo nhu vay thieu dang ke. Do lai tren wz hang so: ban cu thap hon that
    trung binh 18.9% (tu 7.1% den 25.7% tuy pha), du thoi ti so len ~1.23. Con so
    1.13 do duoc nam gon trong khoang do.
    Da sua bang cach noi suy tuyen tinh wz o hai bien. Kiem lai tren wz hang so va
    wz tang tuyen tinh: sai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
2026-10-01 slam: tra min_pass_through ve 2 va ha nguong di chuyen xuong 0.2
    Trieu chung: LiDAR quet toi xa nhung vung trang khong lan ra, phan lon ban do
    van xam. Doc Karto.h UpdateCell():
    if (cellPassCnt > m_pMinPassThrough->GetValue()) { ... } // khong thoa ->
    // giu nguyen xam
    tuc o chi duoc to - trang hay den deu vay - khi so tia DI XUYEN QUA no lon hon
    min_pass_through. Toi nang tham so do tu 2 len 3 o commit truoc, tuc tu "can
    >=3 luot" thanh "can >=4 luot". Do la sai.
    No cong huong voi mot gioi han hinh hoc: 320 tia tren 360 do = 0.0196 rad/tia,
    nen o khoang cach d hai tia lien nhau cach nhau d*0.0196 m. Voi o luoi 0.05 m
    thi tu d >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
2026-10-01 tools: them check_lidar_offset.py - do goc lech giua anh quet va mui xe
    Trong RViz truc do cua xe khong huong ve canh cua ma xe dang quay mat vao.
    TF khong bi trao truc: do chi xuong, luc chi sang phai, quay (0,-1) di +90 do
    duoc (1,0) - dung he thuan tay phai. Va cac o tuong den TRUNG KHOP voi cham do
    cua anh quet, tuc ban do va anh quet nhat quan voi nhau, chi co huong xe la
    lech so voi ca hai. Day la dau hieu cua LIDAR_ANGLE_OFFSET_DEG sai - so 90 do
    tu truoc den nay la so dat tam, chua ai do.
    Nhac lai cho ro: lech goc co dinh KHONG lam meo ban do, nen no khong phai thu
    pham cua may ban do hong truoc do. Nhung no VAN phai sua truoc khi chay Nav2,
    vi Nav2 se thay vat can lech di dung chun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
2026-10-01 firmware: LIDAR_ANGLE_OFFSET_DEG 90 -> 180, do duoc tren xe that
    Dat mot vat rong ~36 cm ngay truoc mui xe cach 1.20 m, chay
    tools/check_lidar_offset.py (trung vi truot +-2 bin, 25 vong quet): vat hien ra
    o phuong vi 90.0 do thay vi 0 do. Khoang cach do duoc 1.20 m khop dung voi cho
    dat, nen cong cu bat dung vat chu khong bam vao tia rac.
    bearing phat ra = (360 - OFFSET) - angle_lidar, nen tang OFFSET len bao nhieu
    la keo bearing xuong bay nhieu. Du 90 -> OFFSET 90 + 90 = 180.
    So 90 cu la so dat tam tu dau du an, chua ai do. Con so tron 90 do cung hop ly
    ve co khi: LiDAR gan lech dung mot goc vuong.
    Loi nay KHONG phai thu pham cua may ban do hong truoc do - lech goc co dinh
    khong lam meo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
2026-10-01 firmware: tru bias gyro Z; teleop: tang toc do quay
    Trieu chung nguoi dung bao: ban do khop luc dau, chay mot luc bat dau lech,
    quay ve diem xuat phat thi sai vi tri. Do la troi TICH LUY.
    USE_GYRO_FOR_YAW = 1 nen goc quay cua odometry duoc tich phan tu gyro_z trong
    odom_update(), va truoc day khong co buoc tru bias nao. Phep tich phan khong
    tha thu cho bias: lech 0.005 rad/s la odom tu quay them 17 do moi phut du xe
    dung yen. Log Serial cu luc xe dung yen in gyroZ -0.02 / +0.03, tuc dao dong
    quanh 0 - nhung neu TRUNG BINH khac 0 thi no cong don mai.
    calibrate_gyro_bias(): lay 200 mau trong 2 giay luc khoi dong roi tru. Do moi
    lan boot chu khong de hang so chet, vi bias MEMS troi theo nhiet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
2026-10-01 kien truc: dua odometry tu ESP32 len laptop
    ESP32 gio chi lam nhung viec buoc phai o gan phan cung: doc LiDAR, doc encoder,
    doc BNO055, PID dong co, nhan /cmd_vel. Moi tinh toan uoc luong nam tren laptop.
    ESP32 phat them /joint_states (goc banh TICH LUY, rad + toc do goc) va bo
    /odom, /tf. Node moi scripts/wheel_odometry.py ghep /joint_states voi /imu/data
    thanh /odom va TF odom->base_footprint.
    DIEU KIEN DE KIEN TRUC NAY DUNG: gui gia tri TICH LUY, khong gui so gia.
    Da do tren chinh duong truyen nay: /odom co duoi tre toi 32 ms, /scan mat 7
    khoang > 200 ms trong 12 giay. Voi so gia thi moi goi roi la mat han quang
    duong do, vinh vien. Da kiem bang cach goi thang callback voi du lieu gia: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
2026-10-01 tools: check_tf.py bao sai tuoi cua transform
    Cong cu bao "odom -> base_footprint tuoi +1.404 s" sau khi chuyen odometry len
    laptop, nhin nhu node bi treo. Do lai thi khong phai:
    /odom 600 msg = 50.0 Hz, khoang cach trung vi 20.0 ms, 0 khoang > 200 ms
    TransformListener mac dinh chi nhan TF trong luc node duoc spin. Cong cu ngung
    spin, in cay TF (all_frames_as_string kha cham) roi MOI doc gio - nen "tuoi"
    tinh ra gom ca thoi gian in an.
    Sua: doc gio va tra cuu ngay khi vua ngung spin, in sau. Do lai: tuoi -0.019 s.
    Them mot dong giai thich TF tinh co stamp = 0 nen tuoi cua chung vo nghia, truoc
    day dong do lam nguoi doc tuong co van de.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
2026-10-01 hieu chinh: wheel_radius 0.03225 -> 0.03300, do duoc tren san
    check_odom_scale.py --distance 2.0 tren doan 2.00 m danh dau bang thuoc:
    odom bao : 1.955 m -> sai -2.3%, he so can nhan 1.0230
    lech ngang : -0.019 m
    doi huong : -0.9 do
    Hai so sau cho thay doan chay thang that, nen ti so dang tin.
    0.03225 * 1.0230 = 0.03300
    Sua vao default cua tham so wheel_radius trong bringup_real.launch.py, KHONG
    vao firmware - tu khi odometry chuyen len laptop thi khong phai nap chip nua.
    Dang chu y: gia tri hieu chinh LON HON ban kinh hinh hoc (0.03225 tu duong
    kinh 64.5 mm), trong khi lop bi nen thi phai cho ban kinh NHO hon. Nghia la
    he so 1.0230 nay khong chi la ban kinh. No gop ca ENC_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
2026-10-01 tools: them check_encoder_ppr.py
    Tach hai nguon sai lech ma check_odom_scale.py khong tach duoc. Quang duong =
    (so xung / ENC_PULSES_PER_REV) * 2*pi * wheel_radius, nen mot phep chay thang
    chi cho tich cua hai cai. Quay tay banh dung 10 vong thi goc phai doi dung
    62.832 rad, khong dinh gi den ban kinh -> tach duoc.
    Can thiet vi hieu chinh tren san cho wheel_radius 0.03300, LON HON ban kinh
    hinh hoc 0.03225, trong khi lop bi nen thi phai cho ban kinh NHO hon. Nghi
    ENC_PULSES_PER_REV = 1200 (lay tu sketch goc, chua ai kiem) moi la thu pham.
    Doc duoc tu ROS vi /joint_states gio la radian - truoc khi doi kien truc thi
    phai doc count tren Serial.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
2026-10-01 hieu chinh: bo wheel_radius 0.03300, phep do khong lap lai duoc
    Hai lan do chay thang 2.00 m voi CUNG mot cau hinh cho hai ket qua khac han:
    lan 1: odom 1.955 m (he so 1.023)
    lan 2: odom 3.494 m (he so 0.572)
    gap 1.79 lan. Da kiem: node dang chay voi wheel_radius 0.03225 trong CA HAI
    lan - launch chua duoc khoi dong lai sau khi doi default - nen khong phai do
    phan mem doi. Chi co mot node odometry va mot publisher /odom, khong bi nhan doi.
    Nen khac biet nam o lan chay that: quang duong thuc te khac, hoac banh truot.
    San trong anh la gach bong. Khong con nao trong hai so dang tin, va ghi mot lan
    do duy nhat vao default la sai - tra ve ban kinh hinh hoc 0.03225.
    check_odom_scale.py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
2026-10-01 firmware: them encoder_test.ino de do ENC_PULSES_PER_REV
    So 1200 trong esp32_agv_base.ino chep tu sketch goc, chua ai kiem. Voi
    JGA25-370 thi so dem tren mot vong truc ra = PPR_encoder * he_so_dem *
    ti_so_hop_so, ca ba deu khac nhau giua cac lo (PPR 11 hoac 13; hop so 1:9.6,
    1:21, 1:34, 1:56...). Doan khong duoc.
    Sketch rieng, khong micro-ROS khong Wi-Fi khong chay dong co. Dung
    attachHalfQuad va cung bo chan voi firmware chinh nen so do ra dat thang vao
    ENC_PULSES_PER_REV duoc. Go r de ve 0, quay tay N vong, go N -> no in so
    xung/vong, do lech so voi 1200, va canh bao neu so dem giam khi quay toi
    (INVERT_ENC_x sai).
    Bien dich sach: 300196 byte (22%), partition mac dinh du.
    Co-Authored-By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
2026-10-01 encoder_test: bo canh bao gay hieu nham ve dau am
    Sketch canh bao "so dem GIAM khi quay toi" cho banh trai, nhung do la trang
    thai DUNG: hai dong co lap doi xung nen khi xe tien chung quay nguoc chieu
    nhau, quan he pha A/B cho dau nguoc nhau, va dung la hai co INVERT_ENC_x phai
    KHAC nhau (hien la L=true, R=false). Chi dang lo khi CA HAI cung dau.
    Gio in thang dau do ung voi INVERT_ENC_x nao, va doi loi khuyen cuoi tu "lam
    tron den so nguyen dep" sang "lay trung binh hai banh, khong can so tron" -
    so do duoc la 2141/2134, khong gan so tron nao.
2026-10-01 firmware: ENC_PULSES_PER_REV 1200 -> 2150, do duoc bang encoder_test.ino
    Quay tay banh, doc xung tho:
    10 vong : TRAI 21614 -> 2161.4 PHAI 21375 -> 2137.5
    3 vong : TRAI 6423 -> 2141.0 PHAI 6401 -> 2133.7
    Bon so deu quanh 2140-2160. Lay trung binh phep 10 vong -> 2150.
    So cu 1200 chep tu sketch goc, chua ai kiem - sai 78%.
    Khop voi phan cung: encoder 11 PPR * 2 (attachHalfQuad dem 2 canh) = 22 xung
    moi vong truc MOTOR; 2150/22 = 97.7 la ti so hop so. Hop so hanh tinh co nho
    hiem khi ra ti so nguyen nen 1:97.7 binh thuong, khong ep ve 2200 (=1:100).
    DAY LA NGUYEN NHAN odometry bao thua ma truoc do khong giai thich duoc:
    do chay thang lan 2 : 2.00 m that -> odom 3.494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
2026-10-01 tools: check_encoder_ppr mang hang so cu 1200
    Firmware da doi sang 2150 nhung PPR_NOW trong cong cu van la 1200, nen neu
    chay lai de kiem chung thi no se so voi moc sai. Cung lop loi voi chuyen
    check_odom_scale tinh he so tren 0.03300 trong khi node chay 0.03225.
2026-10-01 hieu chinh: wheel_radius 0.03281, lan nay bang phep do lap lai duoc
    Ba lan chay thang 2.00 m sau khi sua ENC_PULSES_PER_REV 1200 -> 2150:
    1.967 m (-1.6%) lech ngang -0.100 m doi huong -5.3 do
    1.953 m (-2.3%) lech ngang -0.086 m doi huong -9.3 do
    1.978 m (-1.1%) lech ngang -0.050 m doi huong -3.4 do
    trung binh 1.966 m, tan mat 1.3%. He so 2.000/1.966 = 1.0173.
    0.03225 * 1.0173 = 0.03281
    Khac han lan truoc, khi ba phep tuong tu cho 1.955 roi 3.494 m (gap 1.79 lan)
    va phai bo. Chenh lech do chinh la 2150/1200 = 1.79 - hang so encoder la thu
    pham, khong phai banh truot nhu toi suy doan.
    LUU Y da ghi vao launch: 0.03281 KHONG con la ban kinh vat ly. No lon hon ban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
2026-10-01 wheel_odometry: them service /reset_odometry
    Truoc day muon dua odom ve goc phai khoi dong lai ca launch. Gio:
    ros2 service call /reset_odometry std_srvs/srv/Empty {}
    Khong dong vao /joint_states: goc banh tich luy van chay tiep, node chi bo moc
    cu (_prev = None) nen message sau lam moc moi - reset khong tao buoc nhay gia
    trong quang duong. Neo lai ca _imu_yaw0 de huong dang quay mat thanh 0 do.
    Da kiem: service hien ra dung kieu std_srvs/srv/Empty.
2026-10-01 tools: them check_slam_drift.py, theo doi luong slam bu cho odometry
    Nguoi dung bao anh quet khong con bam tuong sau khi chay mot luc: cham do lech
    len tren khoi hang o den khoang 0.3 m, kem lech goc nhe.
    map->odom chinh la phan slam_toolbox phai bu vi odometry sai, nen theo doi no
    theo thoi gian se biet hong o dau:
    tang dan deu -> odometry troi that, khop scan van bam kip
    dung yen khi xe chay -> khop scan da mat dau
    nhay giat -> khop scan dang vat lon
    BAN DAU CONG CU NAY SAI: no khong he biet xe co chay hay khong, nen khi do luc
    xe dang do thi ket luan nham "khop scan da mat dau". Thuc ra map->odom dung yen
    luc xe do la DUNG, vi minimum_travel_distance 0.2 ngh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
2026-10-01 sua anh quet lech khoi ban do: stamp /scan, time_increment, yaw tu gyro
    Trieu chung: lai vong quanh phong thi anh quet lech dan khoi tuong, map->odom
    yaw dao dong -6 -> -20 -> -11 do (check_slam_drift.py), khong trôi mot chieu.
    1) FIRMWARE - stamp /scan dat o GIUA vong quet thay vi luc gui.
    publish_scan_if_ready() chay ngay khi vong quet KET THUC, nhung diem duoc
    thu rai deu trong 0.116 s truoc do. slam_toolbox ap mot tu the cho ca vong
    theo stamp, nen luc quay tu the tre trung binh nua vong: 1.2 rad/s * 0.058 s
    = 4 do, dau doi theo chieu quay - dung kieu dao dong do duoc.
    2) FIRMWARE - time_increment = 0 thay vi scan_time/SCAN_BINS.
    Truong nay khai tia i thu o stamp + i*dt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
2026-10-01 docs: ghi ket qua do sau khi sua stamp /scan
    check_slam_drift.py, cung kieu lai vong quanh phong:
    truoc sau sua stamp
    xe di 6.60 m 6.64 m
    dao dong map->odom yaw 13.8 do 3.2 do
    lan sua lon nhat 485 mm 142 mm
    tong luong sua ~2.28 m ~0.74 m
    toc do quay dinh (khong do) 1.74 rad/s
    Khong con lan sua nao tren 150 mm du quay toi 1.74 rad/s -> nguyen nhan dung
    la stamp tre nua vong, khong phai anh quet nhoe khi quay. Khong can ha toc do
    quay hay siet angle_variance_penalty.
    check_lidar_angle.py truoc do cung cho thay goc odometry tot ~1% (gyro -0.99,
    quaternion -1.01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
2026-10-01 firmware: noi suy vong quet ve luoi bin thay vi gan diem vao giua bin
    Nguoi dung thay diem LiDAR xa hon ~2.5 m nhay loan, cang xa cang nhieu.
    Do tren xe (check_scan_noise.py, them muc nhieu THEO KHOANG CACH): nhieu DOC
    tia chi 3-10 mm toi 5 m, khong tang vot sau 2.5 m. Thu tang tuyen tinh theo
    khoang cach la sai so do firmware gan diem vao giua bin 1.125 do: 25-41 mm o
    2.5-5 m, lon hon nhieu cam bien tu ~1.5 m. Tuc phan lon "nhay loan" la do cach
    dong goi, khong phai do LiDAR.
    Co che: gan vao giua bin la DOI GOC MA GIU KHOANG CACH. Voi tuong xien so voi
    tia - tuong xa hau nhu luon xien - dieu do keo diem ra khoi mat tuong, va pha
    mau cua X2 lech giua cac vong nen diem nhay ra nhay vao. Vuo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
2026-10-01 firmware: dua resample_scan vao thang .ino, firmware lai la mot file
    Nguoi dung chep MOT file .ino sang thu muc Arduino rieng de nap
    (D:\CTU\...\Xe_lidar\Xe_lidar.ino), nen scan_resample.h di kem bi bo lai:
    fatal error: scan_resample.h: No such file or directory
    Thay vi bat nguoi dung nho chep them file, dua code vao giua hai dong
    BEGIN/END scan_resample trong .ino va xoa header.
    LAN DAU DAT SAI CHO va bien dich hong theo kieu khac:
    error: variable or field wheel_write_pwm declared void
    error: Wheel was not declared in this scope
    Arduino tu sinh nguyen mau cho MOI ham trong .ino va chen chung ngay TREN ham
    dau tien cua file. Dat resample_scan() ngay sau #include thi no thanh ham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
2026-10-01 Add AMCL localization stage for the real robot
    - localization.launch.py: map_server + AMCL only (no controller), map
    auto-selected by use_sim_time like navigation.launch.py
    - navigation.yaml: AMCL alphas 0.1 from measured odometry error (~1% yaw,
    ~2% distance), update_min_d/a 0.1 for a 6x5 m room
    - real_room_map: map of the real room saved from slam_toolbox
    - check_scan_fit.py: print AMCL std (cm, deg) next to scan-vs-wall error
    - guide: new B5 localization step, navigation renumbered to B6
2026-10-01 Add check_yaw_sources: compare quaternion, gyro and wheel heading
    AMCL drifted 37 cm / 13 deg off on the real robot while the scan fit the
    map to 5 cm at the corrected pose, so the map is fine and the heading is
    suspect. The firmware runs the BNO055 in NDOF mode (bno.begin() default),
    which anchors heading to the magnetometer. This tool accumulates
    quaternion-minus-gyro rotation only while driving straight, where the true
    heading does not change, so a swing there can only come from the
    magnetometer, not from gyro scale or wheel slip.
2026-10-01 wheel_odometry: detect a dead IMU and fall back to wheel heading
    After an ESP32-only reset the BNO055 kept answering begin() but every
    read returned zeros (quaternion 0, gyro 0). The node accepted those
    packets: imu_gyro integrated zero and imu_quaternion froze on the last
    heading, so odom believed the robot never turned and AMCL lost the robot
    within seconds.
    - Drop IMU packets whose quaternion is not unit length.
    - If no valid packet arrives for 0.5 s, take heading from the wheels,
    starting from the last fresh IMU packet so the detection window is not
    lost, and log an error telling the user to power-cycle the robot.
    - When the IMU returns, re-anchor so a rebooted BNO055 with a differe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
2026-10-02 Localization: stop losing distance over Wi-Fi gaps, tighten AMCL
    Measured from a 355 s bag on the real robot (every scan, true pose =
    best scan-to-map fit): AMCL position error while driving was median
    6 cm, p90 17 cm, max 26 cm, appearing in jumps right after starts and
    stops. Cause: /joint_states had gaps of 1.00-1.02 s and wheel_odometry
    discarded any step longer than 1.0 s - 9 to 14 cm of travel lost each
    time. The gaps come from the ESP32: /joint_states was RELIABLE, and a
    reliable micro-ROS publish blocks up to 1000 ms waiting for an ACK
    whenever Wi-Fi drops a packet, stalling /scan and /imu/data too.
    - wheel_odometry: keep cumulative wheel travel across gaps; reject only
    steps fast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
2026-10-02 wheel_odometry: no false alarms from the idle clock re-sync
    The new firmware still pauses ~2.2 s about once a minute while idle
    (clock re-sync, only when no /cmd_vel). Raise the IMU-loss alert to 3 s
    and warn about a long /joint_states gap only if the wheels actually
    moved during it.
2026-10-02 firmware: revert /joint_states to RELIABLE - best-effort delayed commands
    With /joint_states best-effort, the time from a /cmd_vel command to the
    wheels turning went from a median of 87 ms (old firmware, run 1) to
    2.9 s, max 6.2 s (run 3), measured from bags with the ESP32/laptop clock
    offset removed. The uplink stayed fast; commands reached the robot
    seconds late, so it kept driving after the stick was released.
    Likely mechanism (unverified): waiting for the ACK of a reliable publish
    runs the XRCE session and drains incoming packets, /cmd_vel included.
    The 1 s stalls that motivated the change no longer lose distance:
    wheel_odometry now keeps cumulative wheel travel across gaps.
    Co-Author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
2026-10-02 wheel_odometry: hold heading while both wheels are still
    Run 3 on the real robot: standing still for 5 minutes, the BNO055 NDOF
    quaternion rotated 15 deg (gyro < 1 deg). AMCL followed it, so in RViz
    the scan slowly rotated off the map while the robot did not move. With
    both wheels still the robot cannot turn, so any IMU heading change then
    is drift: hold the heading and re-anchor the quaternion so motion resumes
    without a jump. Replaying run 1 (driving) gives the same accuracy as
    before (median 3.6 cm, p90 6.3 cm while driving) and a lower heading
    error at rest (0.2 vs 0.8 deg median).
    imu_gyro: bridge gaps longer than 0.5 s only if the receive-time gap
    matches the stamp gap. An ESP32 clock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
2026-10-02 tools: fix_wsl_clock.sh - stop timesyncd fighting Hyper-V time sync
    Measured: the WSL system clock ran 8.3% slow (kernel tick 9167 instead
    of 10000, set by systemd-timesyncd) and Hyper-V stepped it forward ~2.4 s
    every ~35 s. Laptop timestamps were off by up to +-1.2 s, joy_udp_bridge
    saw each step as a lost gamepad and sent a stop, and the ESP32 clock
    re-sync took 1.2-1.7 s. Disables timesyncd and resets tick/freq.
2026-10-02 firmware: Wi-Fi credentials move to an untracked wifi_config.h
    The ESP32 firmware and two old sketches had the real Wi-Fi password in
    source. It now lives in wifi_config.h next to the .ino (gitignored);
    wifi_config.example.h is the template, and the build stops with a clear
    #error if the file is missing.
2026-10-03 grid: fixed 5x5 board from a config file, 60 cm cells on the real robot
    The grid used to be derived from the bounding box of all free cells in
    /map and clamped to +-4.5 m for the 10x10 m Gazebo room. On the real
    room the box is dragged outside by LiDAR rays leaking through the door,
    so nodes landed in walls; the robot radius was the old 0.6 m model; and
    with no /map it silently fell back to the 10x10 m grid.
    - grid_board.py: board geometry from config/grid_real.yaml (5x5, 0.6 m,
    row 3 col 3 at the robot position read on 2026-10-03, -0.545/+0.035)
    or grid_sim.yaml (old +-4 m sim grid). On /map it drops nodes closer
    than 25 cm and edges closer than 20 cm to walls, objects or large
    unk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
2026-10-03 grid: drive only along the edges - straight segments + Regulated Pure Pursuit
    First Nav2 run on the real robot: the robot barely moved. Log showed
    "Failed to make progress" every 10 s, MPPI at 7-8 Hz instead of 20 Hz,
    and collision_monitor stopping on every ~1 s /scan gap. MPPI and A* also
    pick curved paths that cut across the board cells.
    - grid_navigator sends each BFS route as straight segments lying on the
    board edges (collinear edges merged) directly to the follow_path action
    of controller_server; A* is no longer used for the board. If the robot
    is not on a node, a first short segment brings it there.
    - Controller MPPI -> Regulated Pure Pursuit: rotate in place when the
    heading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
2026-10-03 grid: keep going forward after a Nav2 failure; slower straight, faster spin
    Real robot, recorded velocity chain (/cmd_vel_nav -> smoothed -> cmd_vel
    -> wheel speeds): Nav2 commanded correctly but the wheels could not
    follow.
    - Rotate in place at 1.0 rad/s (29 rpm per wheel, PWM ~82): wheels
    stalled 1-2 s, the reversing wheel never turned.
    - At 0.25 m/s both wheels saturated at 5.35 rad/s (0.175 m/s, PWM 255),
    so neither could go faster and the robot could not steer; RPP kept
    commanding +0.3 rad/s with no effect. Earlier teleop reached 0.33 m/s,
    so the battery has likely dropped.
    - After "Failed to make progress", grid_navigator re-ran BFS from the
    nearest node - the one just behind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
2026-10-03 grid: own rotate-in-place with lag compensation; PID breakaway + anti-windup
    Real robot: rotations started slowly and overshot. A kinematic fake
    robot with the measured 0.3 s command-to-wheel lag reproduces it: RPP
    rotates at a constant 1.3 rad/s and cuts the command at the target, so
    the robot drifts 28-40 deg past and hunts back and forth. Nav2 Jazzy's
    RotationShimController was tried and behaves the same (constant speed,
    no deceleration).
    grid_navigator now does the rotation at the start of each segment
    (config: rotate: in grid_real.yaml): it predicts the remaining angle
    after the commands already sent in the last `lag` seconds and the motor
    time constant reach the wheels, decelerates as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
2026-10-03 grid: stop within 3 cm, final heading within 5 deg
    - Goal checker xy tolerance 5 cm -> 3 cm; grid_navigator SNAP_DIST 3 cm.
    - Final heading is not enforced by Nav2's goal checker: RPP would rotate
    at constant speed at the goal and overshoot. Instead, after the last
    segment grid_navigator aligns the robot to the last segment's heading
    with its lag-compensated rotation when it is off by more than 5 deg.
    Fake robot with 0.3 s lag: final position error 0.8-1.7 cm, heading
    error 0.0-0.2 deg; rotations end 0.6-2.1 deg off.
2026-10-03 grid: smooth start, destination heading (D/T/B/N), live IMU status line
    - Start stutter: when the robot stood a few cm off the start node, a
    separate "go to node" segment in an arbitrary direction made it
    rotate, creep 3-10 cm and rotate back. Within 15 cm the first edge
    segment now simply starts at the robot's position. Rotation settle
    wait 0.3 -> 0.15 s.
    - Firmware: the static-friction kick toggled on the instantaneous wheel
    speed around 3 rpm (kick off, wheel slows, kick on again) - jerky
    starts. It is now latched once per start and re-armed only when the
    command returns to zero or the wheel stalls for 0.3 s. Needs flashing.
    - After row/col the operator chooses the heading a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
2026-10-03 wheel_odometry: hold heading only if the gyro is quiet too
    Rotating the robot by hand (lifted, or wheels slipping) left the wheels
    still, so the "wheels still -> hold heading" rule froze the odom yaw;
    the scan rotated against the map and AMCL lost the robot at once. Hold
    now also requires |gyro_z - bias| < 0.05 rad/s; magnetometer drift
    (~0.001 rad/s) is still blocked. Gyro bias learning skips samples where
    the gyro sees rotation, so a manual turn is not learned as bias.
    Test: 90 deg turn by hand with wheels still -> odom follows (+90.0 /
    +89.7 deg in quaternion / gyro mode); all earlier odometry cases pass.
2026-10-04 1 Xe
    Xe that chay du 4 lo trinh sa ban: 9/9 lan xoay <= 2.8 do, dich <= 1.6 cm.
    - firmware: Kf 1.8 -> 3.0, INTEGRAL_MAX 80 -> 200. Tren san PWM bi kep
    o ~160-190 nen banh chi dat 55-66% lenh; nay chay thang dat 90%.
    - grid_navigator: bo xoay dung gyro (/imu/data) thay omega cua /odom
    (giat 0 / 128 do/s), du doan goc troi them = coast * omega do (0.36 s).
    Xoay bu toi da 5 lan, canh bao CHUA DAT neu con > 3 do.
    Che do xung vong ho cho goc nho (tat mac dinh, pulse_max_deg).
    - grid_navigator: tim duong ngan nhat va it cho re nhat (truoc hay zic-zac).
    - grid_real.yaml: done_deg 3, coast 0.36. navigation.yaml: xy_goal_tolerance 0.02.
    - grid_board: ho tro xoay sa ban (yaw_deg), set_grid_ce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
2026-10-04 docs: bo INA khoi so do day, tra ve nhu cu
    Go phan INA226 them trong commit 1 Xe: so do, bang chan, the linh kien,
    huong dan noi day. GPIO 17 va 19 lai de trong.
2026-10-05 Hai xe tren sa ban (mo phong): giu cho, uu tien xe gan dich, go ket
    - traffic_manager.py: lap duong (it canh, it re, tranh duong xe kia), giu cho
    truoc 2 o, xe gan dich duoc truoc, go ket (di vong / ne sang o trong / doi
    vai / dung ca hai), mat lien lac, vat can.
    - fleet_agent.py: thuc thi cho tung xe (ke thua GridNavigator), chi chay toi o
    duoc phep, noi dai doan dang chay, loc vat can quanh xe khac.
    - tools/fleet_sim.sh, fleet_nav.launch.py, fleet_fake_robot.py: mo phong 2 xe
    (Nav2 that trong namespace, xe ao co LiDAR thay xe kia va vat can).
    - grid_navigator: costmap ten tuong doi, numpy, xoay giu lenh >= 0.15 s,
    mo hinh coast 0 tro lai nhu cu (chi dung cho xe ao).
    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
2026-10-06 firmware: chan theo mach in 2026-10-05
    Encoder B trai 34->18, A phai 4->19, B phai 35->17; PWM LiDAR 18->4.
    Bat dien tro keo LEN noi cho encoder (thu vien mac dinh keo xuong).
    Cap nhat HUONG_DAN_CHAY.md va so do day.
2026-10-06 docs: viet lai HUONG_DAN_CHAY theo kich ban (de doc)
    Moi kich ban ghi so terminal va lenh tung terminal; chi tiet ky thuat
    chuyen xuong phu luc. Cap nhat cac muc cu (thuat toan, da kiem chung).
2026-10-06 firmware: sketch test BNO055 (quet I2C, in goc/gyro/gia toc, do troi, do quay tay)
2026-10-10 Tai lieu: GALLIUM_DRIVER=d3d12 de RViz/Gazebo ve bang GPU tren WSL
2026-10-10 firmware: chon xe bang #define XE (xe 1 giu nguyen ban 1 Xe; xe 2 mach moi + LiDAR nhan khoang cach 1.062)
2026-10-10 firmware XE 2: doi cho chan dong co trai/phai (day noi cheo tren mach moi)
    Lenh tien -> ca hai encoder bao lui -> ESTOP quay nguoc chieu; quay tai cho
    van dung. Doi nhom chan 27/26/25 <-> 33/32/14 cho xe 2, xe 1 giu nguyen.
    Thu ke banh: tien/lui/trai/phai deu dung chieu.
2026-10-10 local costmap luon phat ban day du 5 Hz: xe dung yen thi nut bi chan khong bao gio xoa
    Nav2 mac dinh chi phat /local_costmap/costmap khi khung cuon dich chuyen; xe dung
    yen chi co costmap_updates ma grid_navigator khong nghe. Ve marker 5 Hz.
2026-10-10 Hai xe that: micro-ROS gan ID xe (/agvN), tools/fleet_real.sh, Nav2 gop container
    - firmware: node /agv<XE>/esp32_agv_base_<XE>, moi topic trong /agv<XE>/
    - 1 xe: bringup_real.launch.py xe:=N + ns_relay.py chuyen /agvN/* <-> /*
    - 2 xe: tools/fleet_real.sh (agent + /map chung; moi xe TF/odom/AMCL/Nav2/agent)
    - fleet_nav.launch.py: Nav2 moi xe trong MOT container (qua ~40 tien trinh thi
    DDS LOCALHOST khong do thay tien trinh bat sau) + nap file tham so cho container
    - fleet_agent: SingleThreadedExecutor (MultiThreaded + imu/odom 50 Hz ton 77-90% CPU)
    - traffic_manager: lap duong lan dau that bai thi thu lai 5 lan
    - fleet_fake_robot --esp32: gia ESP32 (joint_states/imu/scan, LiDAR do tuong ba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
2026-10-10 Hai xe that: hieu chinh rieng tung xe, don bo nho chung DDS; agvctl + /diag
    - fleet_real.sh: WHEEL_R_agvN / COAST_agvN cho tung xe (mac dinh = xe 1)
    - fleet_real.sh down/up: fastdds shm clean - cong /dev/shm bi kill -9 bo lai
    lam container Nav2 bat sau khong ai do thay (fleet_agent bao khong thay Nav2)
    - tools/agvctl, tools/fleet_monitor.py, docs/AGVCTL.md, .mcp.json (phien truoc)
    - firmware: /agvN/diag (JSON 1 Hz) + /agvN/estop_reset - CHUA chay tren xe that
2026-10-10 ESTOP cua ESP32 bao ngay ve may tinh; khong xoay vong khi dich la o dang dung
    - firmware: ESTOP / go ESTOP gui ngay {"event": ...} tren /agvN/diag (khong cho 1 s)
    - fleet_agent: nghe diag -> dung xe, state estop, bo qua lenh toi khi go
    - traffic_manager: in do ESTOP + cach go, bo lo trinh xe do (xe kia coi nhu xe do)
    - grid_navigator (1 xe): in do ESTOP, huy lo trinh, khong nhan dich khi dang ESTOP
    - ns_relay: chuyen them /agvN/diag -> /diag
    - grid_navigator/fleet_agent: dich la o dang dung, lech <= 10 cm -> coi nhu da toi
    (xe 2 that bi xoay 158 do de di 4 cm)
2026-10-10 Firmware tach 2 file xe1/xe2; xe 1 dung so do chan mach in moi
    - Xe 1 da chuyen sang mach in 2026-10-05: ca 2 xe encoder 23/18/19/17, PWM LiDAR 4,
    dong co noi cheo (xe 1 gia dinh nhu xe 2 - can thu ke banh). Dau hieu nap nham:
    LiDAR chay het toc 10.8 Hz, encoder khong dem -> ESTOP ket banh.
    - tools/agvctl fw split: sinh firmware/xe1/xe1.ino, firmware/xe2/xe2.ino tu file goc
    va chep sang Arduino IDE Xe_1\Xe_1.ino, Xe_2\Xe_2.ino (kem wifi_config.h)
    - Tai lieu: nap dung file theo xe
2026-10-10 firmware: day dong co rieng tung xe - xe 1 noi thang, xe 2 noi cheo
    Thu ke banh xe 1 voi cau hinh noi cheo: TIEN -> ca hai encoder bao LUI -> ESTOP
    Banh quay nguoc chieu (bao ve qua /diag). Xe 1 ve noi thang nhu mach cu.
2026-10-10 URDF: base_footprint tai tam truc banh; dich la o dang dung - chay toi neu o o phia truoc
    - robot.urdf.xacro: base_footprint duoi truc banh (base_link truoc 14 mm). Truoc day
    xoay tai cho 180 do lam vi tri xe troi 2.8 cm ma odometry khong biet (2 xe that:
    lech dich 3-4.4 cm sau cu xoay cuoi).
    - grid_navigator/fleet_agent stay_put(): o nam truoc mui (<= 30 do) -> chay thang toi
    (Nav2 dung som 8 cm vi vat can thoang qua); ben hong/sau lung va <= 10 cm -> bo qua.
    - Thu that 2 xe: 6 buoc deu dung logic mo phong, khong va (min 59-60 cm).
2026-10-10 Huong dan Kich ban 4 viet lai theo lan chay that; tools/fleet_localize.py, tools/wheel_test.py
    - HUONG_DAN_CHAY Kich ban 4: chuan bi (firmware Xe_1/Xe_2), bat he, dinh vi ICP,
    6 buoc thu kem ket qua that 2026-10-10, xu ly ESTOP, thu dong co, hieu chinh, canh bao
    phia tay sa ban khac ban do
    - tools/fleet_localize.py: ICP quanh vi tri AMCL -> /agvN/initialpose (tu choi khi < 40%)
    - tools/wheel_test.py: thu tien/lui/trai/phai mot xe (ke banh)
    - memory-bank cap nhat
2026-10-10 RViz 2 xe hien day du nhu Kich ban 2 (tools/fleet_viz.py gop cay TF)
    - tools/fleet_viz.py: /agvN/tf(_static) -> /tf voi frame agvN/... (map dung chung),
    /agvN/scan -> /fleet_viz/agvN/scan. fleet_real.sh / fleet_sim.sh tu chay.
    - tools/fleet.rviz: moi xe mot nhom - mo hinh xe (TF Prefix), LaserScan do co 5,
    hat AMCL, local/global costmap, footprint, doan dang chay, local plan.
2026-10-10 fleet_localize: khop kem quanh AMCL thi tu do ca sa ban (25 nut x 4 huong)
    Nguoi dung dat xe o (3,5) va (3,3) nhung bat he voi vi tri mac dinh -> AMCL troi,
    ICP quanh do chi 10-12%. Do sa ban tim dung o + huong trong ~4 s.
2026-10-10 DDS chi dung UDP (FASTDDS_BUILTIN_TRANSPORTS=UDPv4) cho he 2 xe
    Cong bo nho chung /dev/shm/fastrtps_port7015 bi khoa -> container Nav2 xe 2 vo hinh:
    khong costmap, khong follow_path, RViz giu costmap cu (tuong la xoa cham). Do that:
    costmap xe 1 xoa vat can sau 0.3 s; xe 2 0 Hz. Sau khi chi dung UDP: ca hai ~3 Hz.
2026-10-10 Local costmap: o vat can KET mat sau 1-2 s
    O danh dau boi mot diem nhieu ma sau do khong tia nao di qua (sau vat that,
    huong LiDAR khong phan hoi, giua hai tia o xa) thi raytrace khong xoa duoc.
    - navigation.yaml: local costmap ObstacleLayer, observation_persistence 1.0
    - grid_navigator: costmap_decay (clear_except_local_costmap, giu 0.5 m);
    fleet_agent bat 1 s, xe don --decay S
    - fleet_nav.launch.py: tat dong INFO moi lan xoa costmap
    - Tai lieu: tra su co costmap ket, ESP32 BROWNOUT
2026-10-11 2 xe chạy thật
    Hai xe thật chạy đủ 6 bước theo logic mô phỏng, không va. Cập nhật
    memory-bank: trạng thái GitHub, ý tưởng đo hàng bằng camera (chưa làm).
2026-10-11 Do hang bang camera (mo phong): rong x cao, Z tu LiDAR
    - cargo_measure.py: LiDAR (trung vi tung tia, RANSAC) cho mat phang mat hang;
    camera nhin thang: tach nen, 4 mep, chieu len mat phang -> rong, cao
    - cargo_task.py: toi (5,c) quay Bac -> do -> phan loai -> ve (1,k) qua
    traffic_manager; xe da giao dang do o o dich thi lui len hang 2
    - tools/sim_cargo.py: hop hang + camera ao (meo, nhieu, JPEG)
    - fleet_fake_robot: LiDAR ao thay hop, FAKE_LIDAR_NOISE / FAKE_RAYS
    - cargo.yaml, huong dan Kich ban 3, memory-bank
2026-10-13 Hai xe co camera that: ESP32-CAM, hieu chuan, lay hang cot 5 -> tra hang 1
    - firmware/esp32_cam: AI-Thinker, IP tinh .200/.201 (#define XE), /capture, :81/stream, /status
    - tools/esp32_cam_node.py: moi camera mot luong giu anh moi nhat (capture/stream),
    tu noi lai -> /agvN/camera/image_raw; fleet_real.sh up tu bat (CAM=0 tat)
    - tools/cam_calib.py: ban co -> camera_agvN.yaml (de len camera mac dinh)
    - cargo_task: lay hang phia Dong o (2..5,5), tra o hang 1; lenh "<xe> <hang>"; --sim
    - sim_cargo: dat hang theo cargo.yaml place.*
    - Tai lieu: Kich ban 3/4 do hang, tra su co camera
2026-10-14 ESP32-CAM dung firmware stream san; sua DDS roi goi lon tren loopback WSL
    - cargo.yaml cameras.agvN.url = luong http://192.168.1.20x:81/stream (khong nap lai camera)
    - esp32_cam_node: url day du; cargo_measure: anh khac co hieu chuan (cung 4:3) phong len
    - WSL mirrored roi goi UDP > 1472 B tren 127.0.0.1 -> node khong thay nhau:
    tools/fastdds_localhost.xml (goi <= 1400, unicast lo), nap trong fleet_real/fleet_sim
    (va ~/.bashrc); cho Nav2 toi 120 s
    - Tai lieu + memory-bank
2026-10-14 Camera: dung /capture cua CameraWebServer san co (320x240, ~30 KB/s/xe)
2026-10-14 Camera: xe 1 = 192.168.1.201, xe 2 = .200
2026-10-14 cargo_task: sua AMCL bang ICP voi ban do khi dung o lay hang
    Phong co do dac ngoai ban do: AMCL troi ~5 cm / 4-7 do sau 1.8 m (xe that 2026-10-14).
    Xe dung yen o o lay hang -> ICP anh quet voi /map; lech > 1.5 cm / 1.5 do thi gui
    initialpose -> chang ve o tra di dung.
2026-10-14 Camera xe that cao 23.5 cm: dat hang cach o 65 cm, tim mep tren khi thay mat tren hop
    - camera_agv1/2.yaml: x 0.0967 (82.7 mm tu tam xe + 14 mm), z 0.235
    - cargo.yaml place.gap 0.35 -> 0.65 (thay duoc chan hop)
    - cargo_measure.front_top_edge: camera cao hon hop -> mep tren mat truoc = vach sang
    mat tren/mat truoc (offline 320x240: sai <= 3.5 mm)
    - Huong dan: ban co calib.io 8x10 o 20 mm -> --board 9x7 --square 0.020
2026-10-14 Hieu chuan camera theo Nav2 (camera_calibration GUI): cam_calib --ost nhap ost.yaml
2026-10-14 Hieu chuan camera xe 1 (fx 302.4 fy 310.2, RMS 0.23 px); dat hang cach o 85 cm
2026-10-14 Hieu chuan camera xe 2 (fx 297.6 fy 305.1, RMS 0.28 px)
2026-10-14 Camera: xac nhan vi tri lap (82.7 mm truoc tam than xe, cao 23.5 cm, 2 xe giong nhau)
2026-10-14 memory-bank: ket qua do hang that dau tien, LiDAR quet o ~22 cm
2026-10-14 cargo.yaml: LiDAR xe that cao 19 cm, tia chech len
2026-10-14 cargo.yaml: loai cao/rong nhan hang cao toi 45 cm (camera thay toi ~52 cm)
2026-10-15 memory-bank: lan chay 2026-10-15 (xe 2 tron vong, camera xoay, xe 1 ket)
2026-10-15 Goc xoay camera, giao lai khi bi chan tam, firmware tu ket noi lai khi tao entity loi
    - cargo_measure: camera.yaw; estimate_yaw; kep mep anh vao cua so quanh mut LiDAR
    (nguoc sang lam mat na lem: xe that rong +4 cm)
    - tools/cam_extrinsic.py: do yaw camera tu mot hop dat thang -> camera_agvN.yaml
    - sim_cargo: camera ao xoay (thu bu goc)
    - cargo_task: traffic_manager bo lo trinh (WARN dung:) -> cho 5 s giao lai, toi 3 lan;
    luu anh goc _raw.png
    - firmware: dem loi tao entity micro-ROS -> ESP.restart (toi 3 lan, RTC) - het mat /diag
    - Huong dan: buoc do goc xoay camera, tranh nguoc sang, hop cao >= 24 cm
2026-10-15 Do hang that dat: GrabCut gieo tu LiDAR, goc ngoc camera, cao tinh toi san
    - cargo_measure: tach hop GrabCut (hat giong tu LiDAR), mep tren theo do phu 50%,
    tinh mep theo kenh xam, camera.pitch -> chieu cao = mep tren toi san
    - cam_extrinsic --height: do them goc ngoc tu hop biet cao (che do cao toi san)
    - sim_cargo: camera ao ngoc (pitch)
    - camera_agv1: yaw -2.49 pitch -2.29; camera_agv2: yaw +2.92 pitch -1.09
    - Ket qua that: 18.5x32.0 -> 18.7x32.0, 12.0x23.9 -> 13.0x24.1, ve dung o
